nedopc/zxevo/docs/zxevo_firmware_update_eng.odt

(version 11/13/2010)

www.nedopc.com

ZX Evolution.

Firmware update

manual

# Description

Boot loader can update peripheral microcontrollers (ATMEGA128) flash memory.

Peripheral microcontrollers flash memory content FPGA configuration and program for controller (base configuration of ZX Evolution).

User can update base configuration (firmware) manually.

Official configuration locate in NedoPC site (www.nedopc.com). But user can to use alternate configuration from other developers.

Boot loader can update configuration (firmware) with two different way:

- from SD memory card;
- via null-modem cable from other computer.

# Update from SD memory card

1. File with configuration (ZXEVO_FW.BIN) write to root directory of SD memory card. Memory card must be formatted FAT12, FAT16 or FAT32. Insert SD memory card to SD holder on ZX Evolution.
2. Hold pressed soft reset button (hold shorted soft reset contacts on board) and switch on power to ZX Evolution or press on few time hard reset button (short on few time hard reset contacts).

Configuration will update in some seconds.

Updating process is not indicated on display. Errors is signaled by PWR LED (VD6) and beeper. Number of beeps according to next errors:

- 1 – SD memory card not detected;
- 2 – error on reading sector on SD memory card;
- 3 – supported file system not found on SD memory card;
- 4 – file with configuration not found on SD memory card;
- 5 – file with configuration is bad.

# Update via null-modem cable from other computer

1. RS232 connector of ZX Evolution connect via null-modem cable to other computer. Run terminal program on other computer (speed 115200, without parity checking, 8 bit, 2 stop-bit, without CTS).
2. Hold pressed soft reset button (hold shorted soft reset contacts on board) and switch on power to ZX Evolution or press on few time hard reset button (short on few time hard reset contacts).
3. After receiving message «Try update from RS-232...» send file with configuration (ZXEVO_FW.BIN) via X-Modem-CRC protocol.

Can used simple null-modem cable (only three wires):

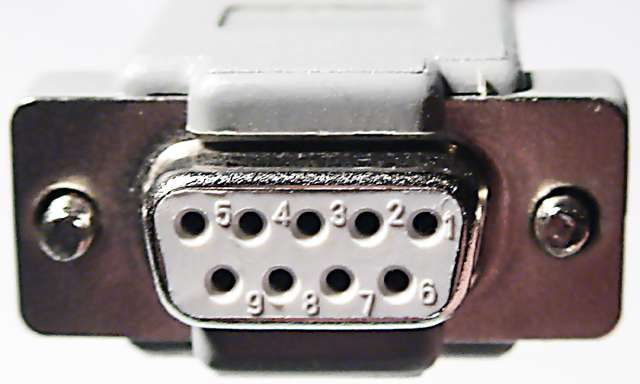
[picture p1: figure]

X1, X2 – D-Sub9F

# Example: Update configuration via null-modem cable from HyperTerminal program

RS232 connector of ZX Evolution connect via null-modem cable to PC computer.

1. Start HyperTerminal program on PC.

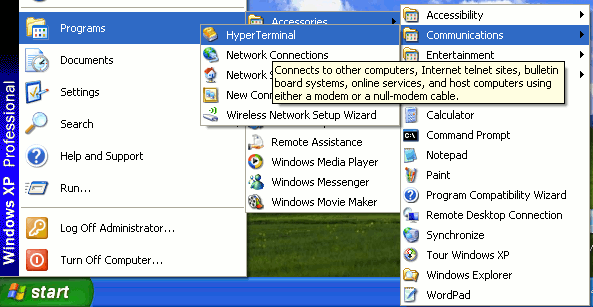
[picture p2: figure]

If HyperTerminal started first time than it view next dialogs.

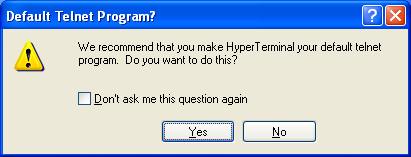
[picture p3: figure]

Set checkbox and press “Yes”.

Set area code (if area code not set and terminal start than dialog views again).

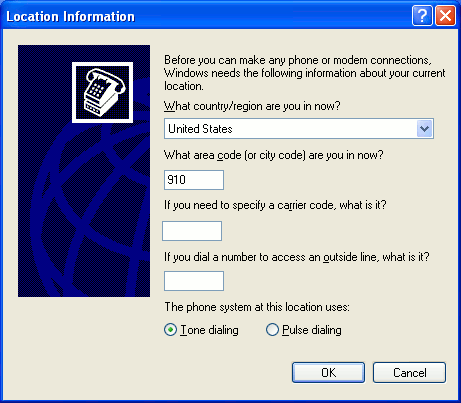
[picture p4: figure]

2. Set the name for connection. Connection settings will saved by this name.

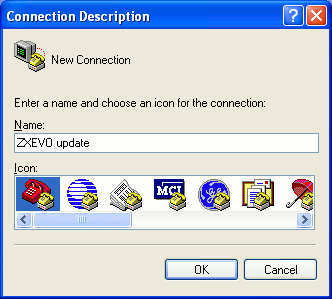
[picture p5: figure]

3. Select port.

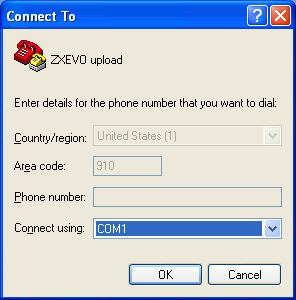
[picture p6: figure]
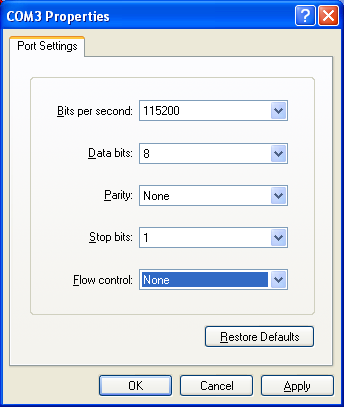
[picture p7: figure]

4. Set port settings as in picture.
5. Hold pressed soft reset button (hold shorted soft reset contacts on board) and switch on power to ZX Evolution or press on few time hard reset button (short on few time hard reset contacts).

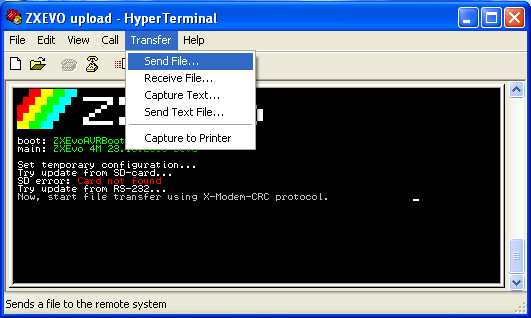
[picture p8: figure]

6. Select file with configuration (ZXEVO_FW.BIN), set protocol «X-Modem» and press button “Send”.

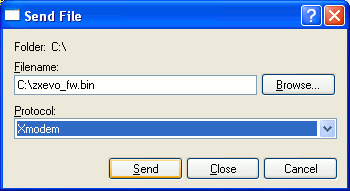
[picture p9: figure]

Warning: If not send file during one minute than ZX Evolution exit from update mode and start current configuration.

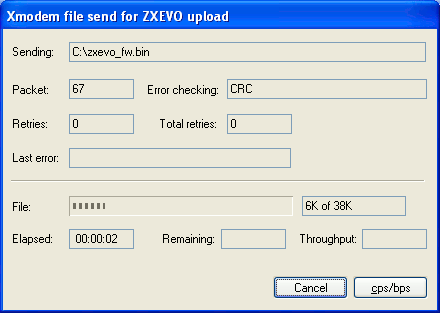
[picture p10: figure]

Transfer take some seconds.

If configuration updated successfully than string with it name and version is shown. Computer start up with new configuration.

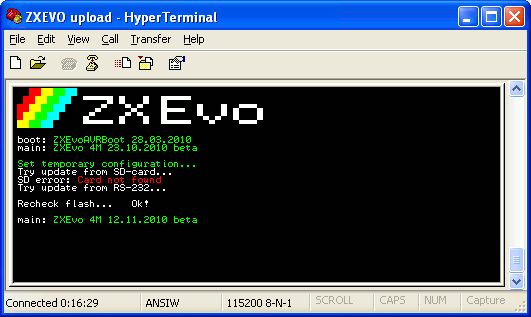
[picture p11: figure]

ZX Evolution. Firmware update manual.
