nedopc/zxevo/docs/schem1.png

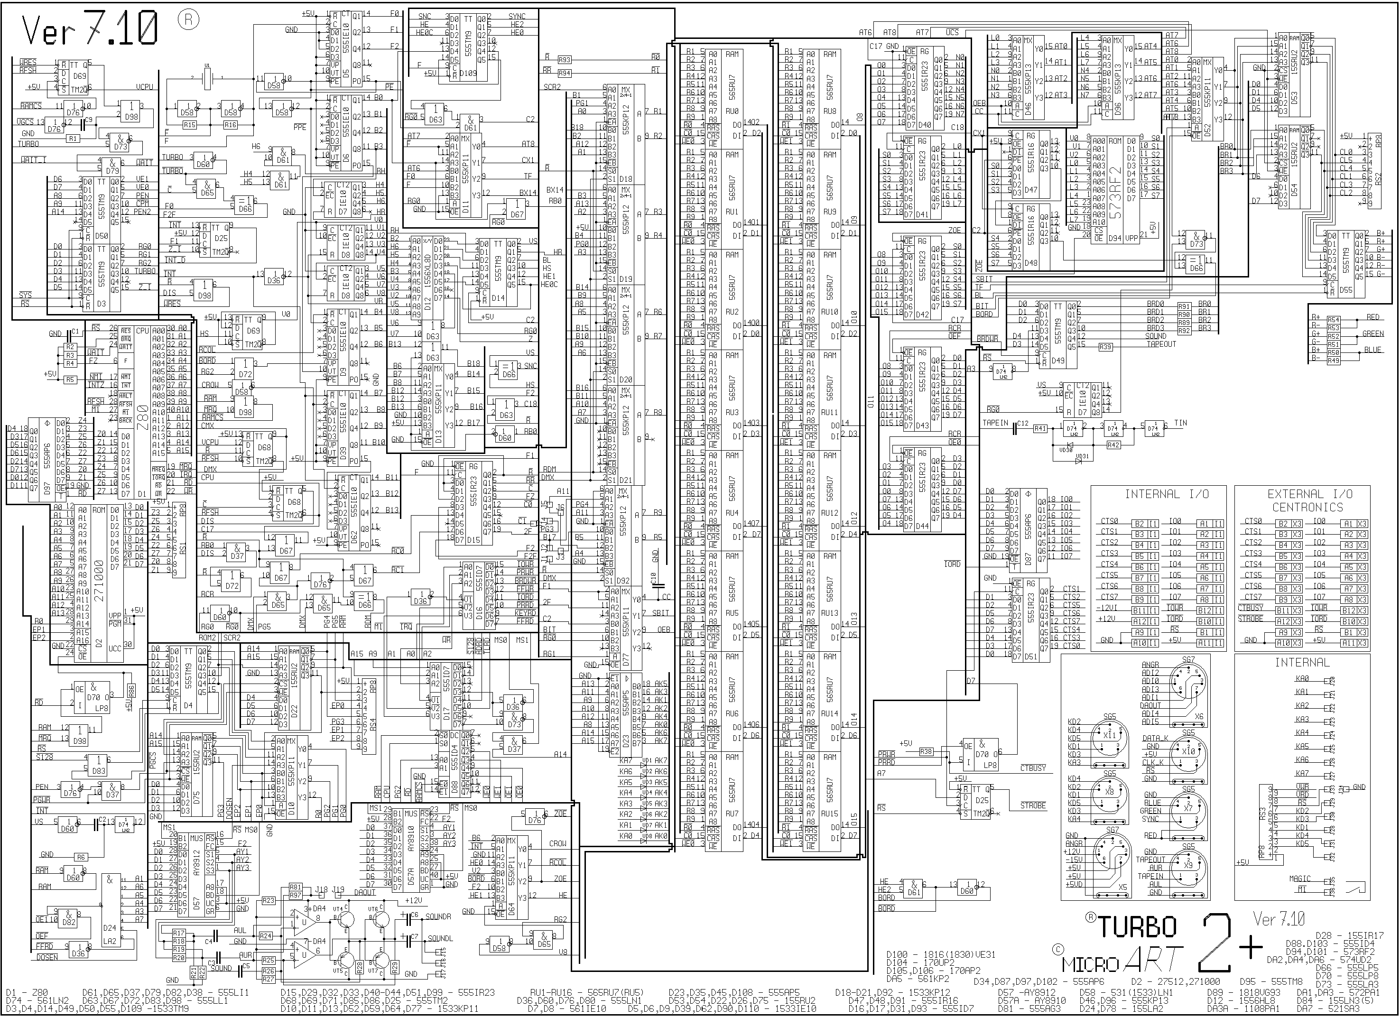
docs/schem1.png
