nedopc/zxevo/docs/schem2.png

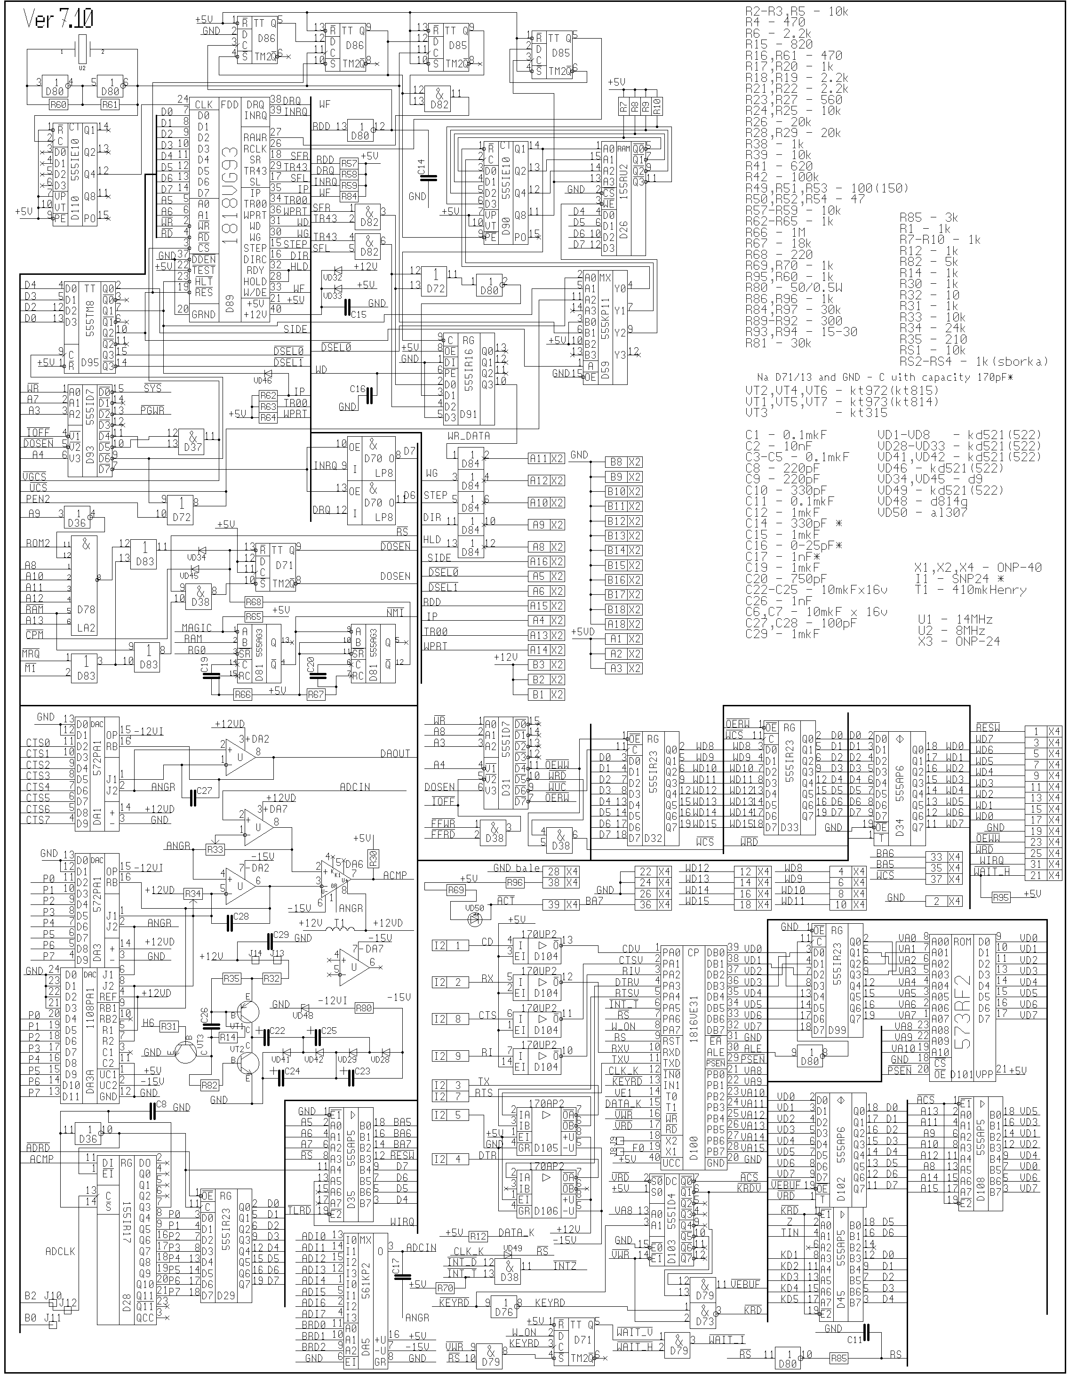
docs/schem2.png
