nedopc/zxevo/fpga/prefetch/dram/arbiter.png

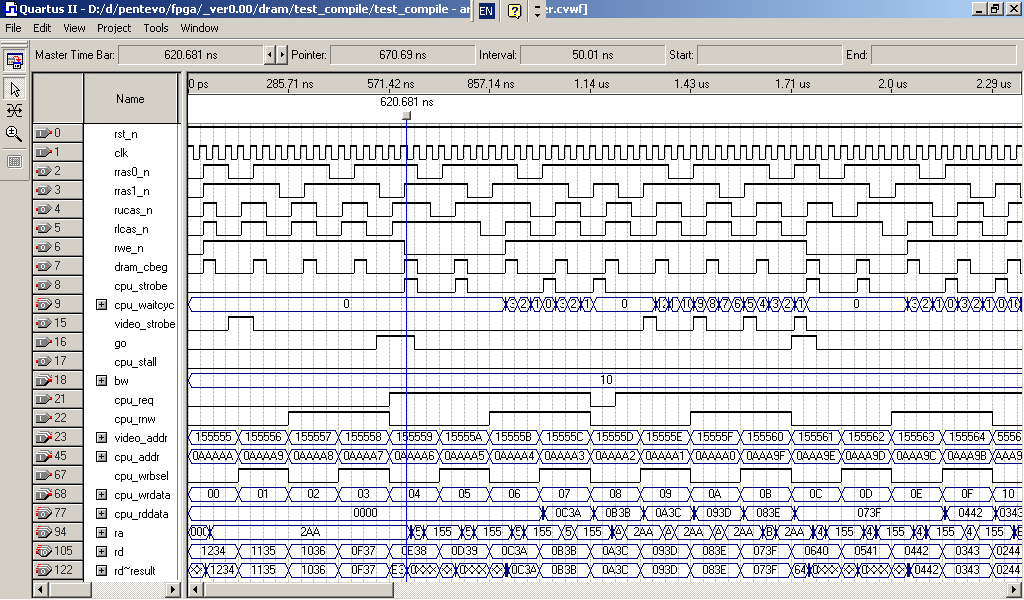
fpga/prefetch/dram/arbiter.png
