nedopc/zxevo/fpga/prefetch/video/shiftted_attr.gif

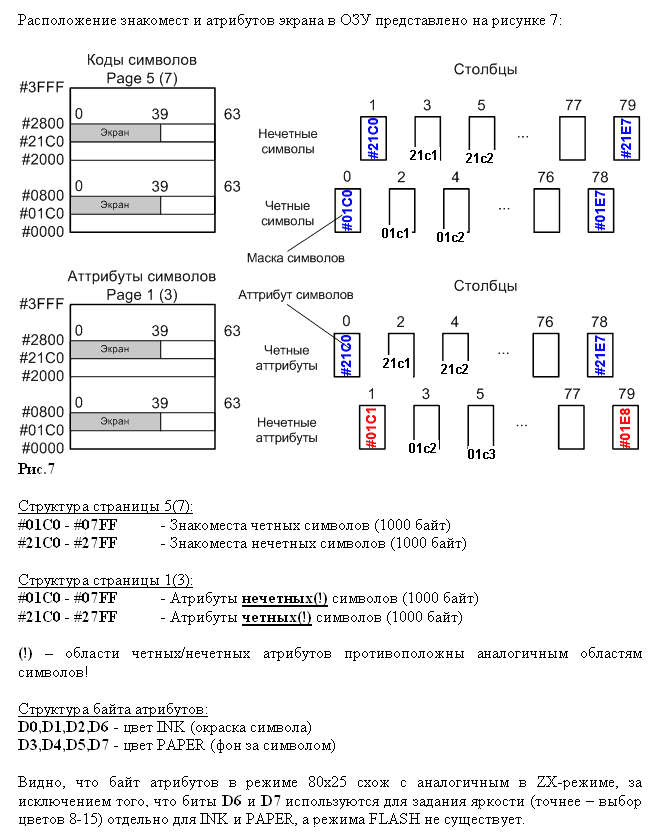
fpga/prefetch/video/shiftted_attr.gif
