nedopc/zxevo/unsupported/flasher/fpga/ZX_FONT.BMP

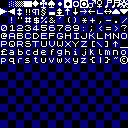
unsupported/flasher/fpga/ZX_FONT.BMP
