nedopc/zxevo/test_n_service/trunk/fpga/font_6x8.bmp

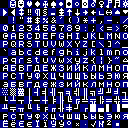
test_n_service/trunk/fpga/font_6x8.bmp
