nedopc/zxevo/pcad/rev_c/TODO.txt

ЗАМЕЧЕННЫЕ НЕДОЧЕТЫ на рев.С:
- Разъем TapeIN (X21) диаметр сигнального пина должен быть увеличен до 2.2мм (компонент RSA103)
- Разъем VGA (X7) нужно отодвинуть вглубь платы на 0.6мм
- Разъем RS232 (X6) нужно отодвинуть в сторону разъема SD на 0.8 .. 1.0мм
- Джампер J1 нужно отодвинуть на 0.5 .. 1.0 мм от X2
- Надпись IDE нужно сделать крупным шрифтом
- Надпись Tape нужно сделать все буквы заглавными
- Надпись RS232 нужно отодвинуть от края платы на 2мм

PCB C2:
+ Разъем TapeIN (X21) диаметр сигнального пина должен быть увеличен до 2.2мм (компонент RSA103)
+ Разъем VGA (X7) нужно отодвинуть вглубь платы на 0.6мм
+ Надпись Tape нужно сделать все буквы заглавными

PCB:
+ Добавил 2 милиметра к плате, чтобы слот влез;
+ Сделал board под miniITX стандарт (ZXBUS слот не лезет).

SCH:
+ Сделал вход для TAPEIN на RSA103;
+ Сделал USB-RS232 bridge на FT232RL;
+ Заменил D3 на 29F040-K (PLCC32 без панельки);
+ Убрал кнопку Hard Reset, оставил только контакты;
+ Добавил IORQ2 и IORQGE2 на XS1;
+ Добавил коннектор (X8,X9) для подсоединения PAL кодера;
+ Добавил +5V и CSYNC (через джамперы) на VGA разъем;
+ Добавил +5V на 10 вывод X19 (как у Мультикарты Caro);
+ Подпачил ZXBUS (добавил 31 контакты);
+ Убрал AT POWER коннектор питания;
+ Устранил перепутывание каналов (левый/правый) на ST-214C (X10);
+ Добавил еще 2 аудио-входа;
+ Добавил PRN интерфейс по стандарту AY принтер;
+ Убрал PAL coder;
+ Убрал R29 (замкнул);
+ Замкнул 4 (DTR) и 6 (DSR) выводы RS232 разъема;
+ Добавил альтернативный разъем держателя SD карт;
+ TurboKey переименован в NMIKey;
+ Выводы 4,5 ATMEGA128 управляют множителем PLL (ICS501M): убран разъем X8, убраны джамперы J2,J3;
+ Убрал лишние резисторы в floppy контроллере;
+ Заменил CPU в DIP корпусе на в QFP корпусе, убрал Z80 в SOIC корпусе (D1*).

LIB:
+ Добавил компонент RSA103;
+ Добавил компонент FT232RL;
+ Добавил 29F040-K PLCC32 (без панельки) ;
+ Добавил компонент 74HCT125;
+ Добавил компонент SP0503BATH;
+ Заменил via на pad-mounting hole у ATXPOWER;
+ Заменил via на pad-mounting hole у SDC09W4;
+ Переименовал EP1K30Q208 в EP1K50Q208;
+ Добавил компонент MINI-USB;
+ Добавил компонент CP2102;
+ Добавил компонент SD01-AP0003;
+ Добавил компонент Z84C0020FEC;
+ Уменьшил диаметр контактов у ATPOWER.
