nedopc/zxevo/tools/unreal_fix/0.37.6/tmp/README

фикс анрыла 0.37.6
делать дифф влом, кучей так в свн.
Оригинальный сорец в комплекте.

1. компилять c.bat -- это для msvc2008. Установки венды для того чтобы компиляция работала --
   см. http://dlcorp.nedopc.com/viewtopic.php?f=28&t=834
   Как вариант, можно прописать установку INCLUDE и LIB переменных в батник, см. как у deathsoft'а.

2. Фикс быстрый и говнокодный. Мифическое ATM3 заменено на фичи пентевы. Но в конфиге оно до сих пор ATM3.
   Конфиг, кстати, сразу настроен под пентеву и zxevo.rom. Всё в комплекте.

Список фич:

1. модель памяти пентевы - порт ЕФФ7 и мегабайт через 7ффд.
2. прерывания через фф77 невозможно запретить
3. Доступны видеомоды через ефф7: алко16ц и хардваре мультиколор
4. впилен текстовый режим #7 (1страничный), выпилен атм2 256х192 текстовый режим.
5. запись фонтрома сделана как в железе - по любому адресу, а не только по 0-2047
6. впилено РАМ0 в 0000-3ффф через ефф7, не тестировал.
7. ещё что-то, мог забыть.

Текстовый режим #7 протестирован той же прогой, которой я тестировал его в железе.

Фичи памяти - аласмом с драйвером P1MB, моими памятетестами.

Экраны пентагона -- ballquest'ом (оба работают - алко16ц и атм16ц), HexaFixa (хвмц).

10.01.2012, lvd.
