nedopc/zxevo/pcad/rev_b/TODO.txt

              ZX Evo revision B
             ===================

+ Исправил шаблон PS/2 клавиатуры-мыши
+ Увеличил площадь радиатора у 78M05 примерно в два раза
+ Исправил ОЕ на ICS501
+ 12V на слоты подается теперь через джампер (чтобы ААА не жжег)
+ добавил направляющие для разъема ATX питания
+ увеличил контактные площадки дросселей
+ уменьшил размер платы
+ убрал J4
+ замкнул OE ICS501 на +5в (по совету LVD)
+ сделал у диодов 4148 универсальную площадку (на смд и выводные)
+ у ZXBUS сделал указатель первого вывода
+ исправил ошибку сброса ВГ93 (завел VG_RES на D19)
+ сделал ключ FDD как на ПЦ платах (5-ый контакт) 
+ добавил надписи "HDD Led", "PWR Led", "ZX Keyboard/ZX Joystick", "Slot1", "Slot2"
+ опустил разъем VGA чтобы было паралельно DB15
