nedopc/zxevo/docs/revC/zxevo_sch_revc.pdf

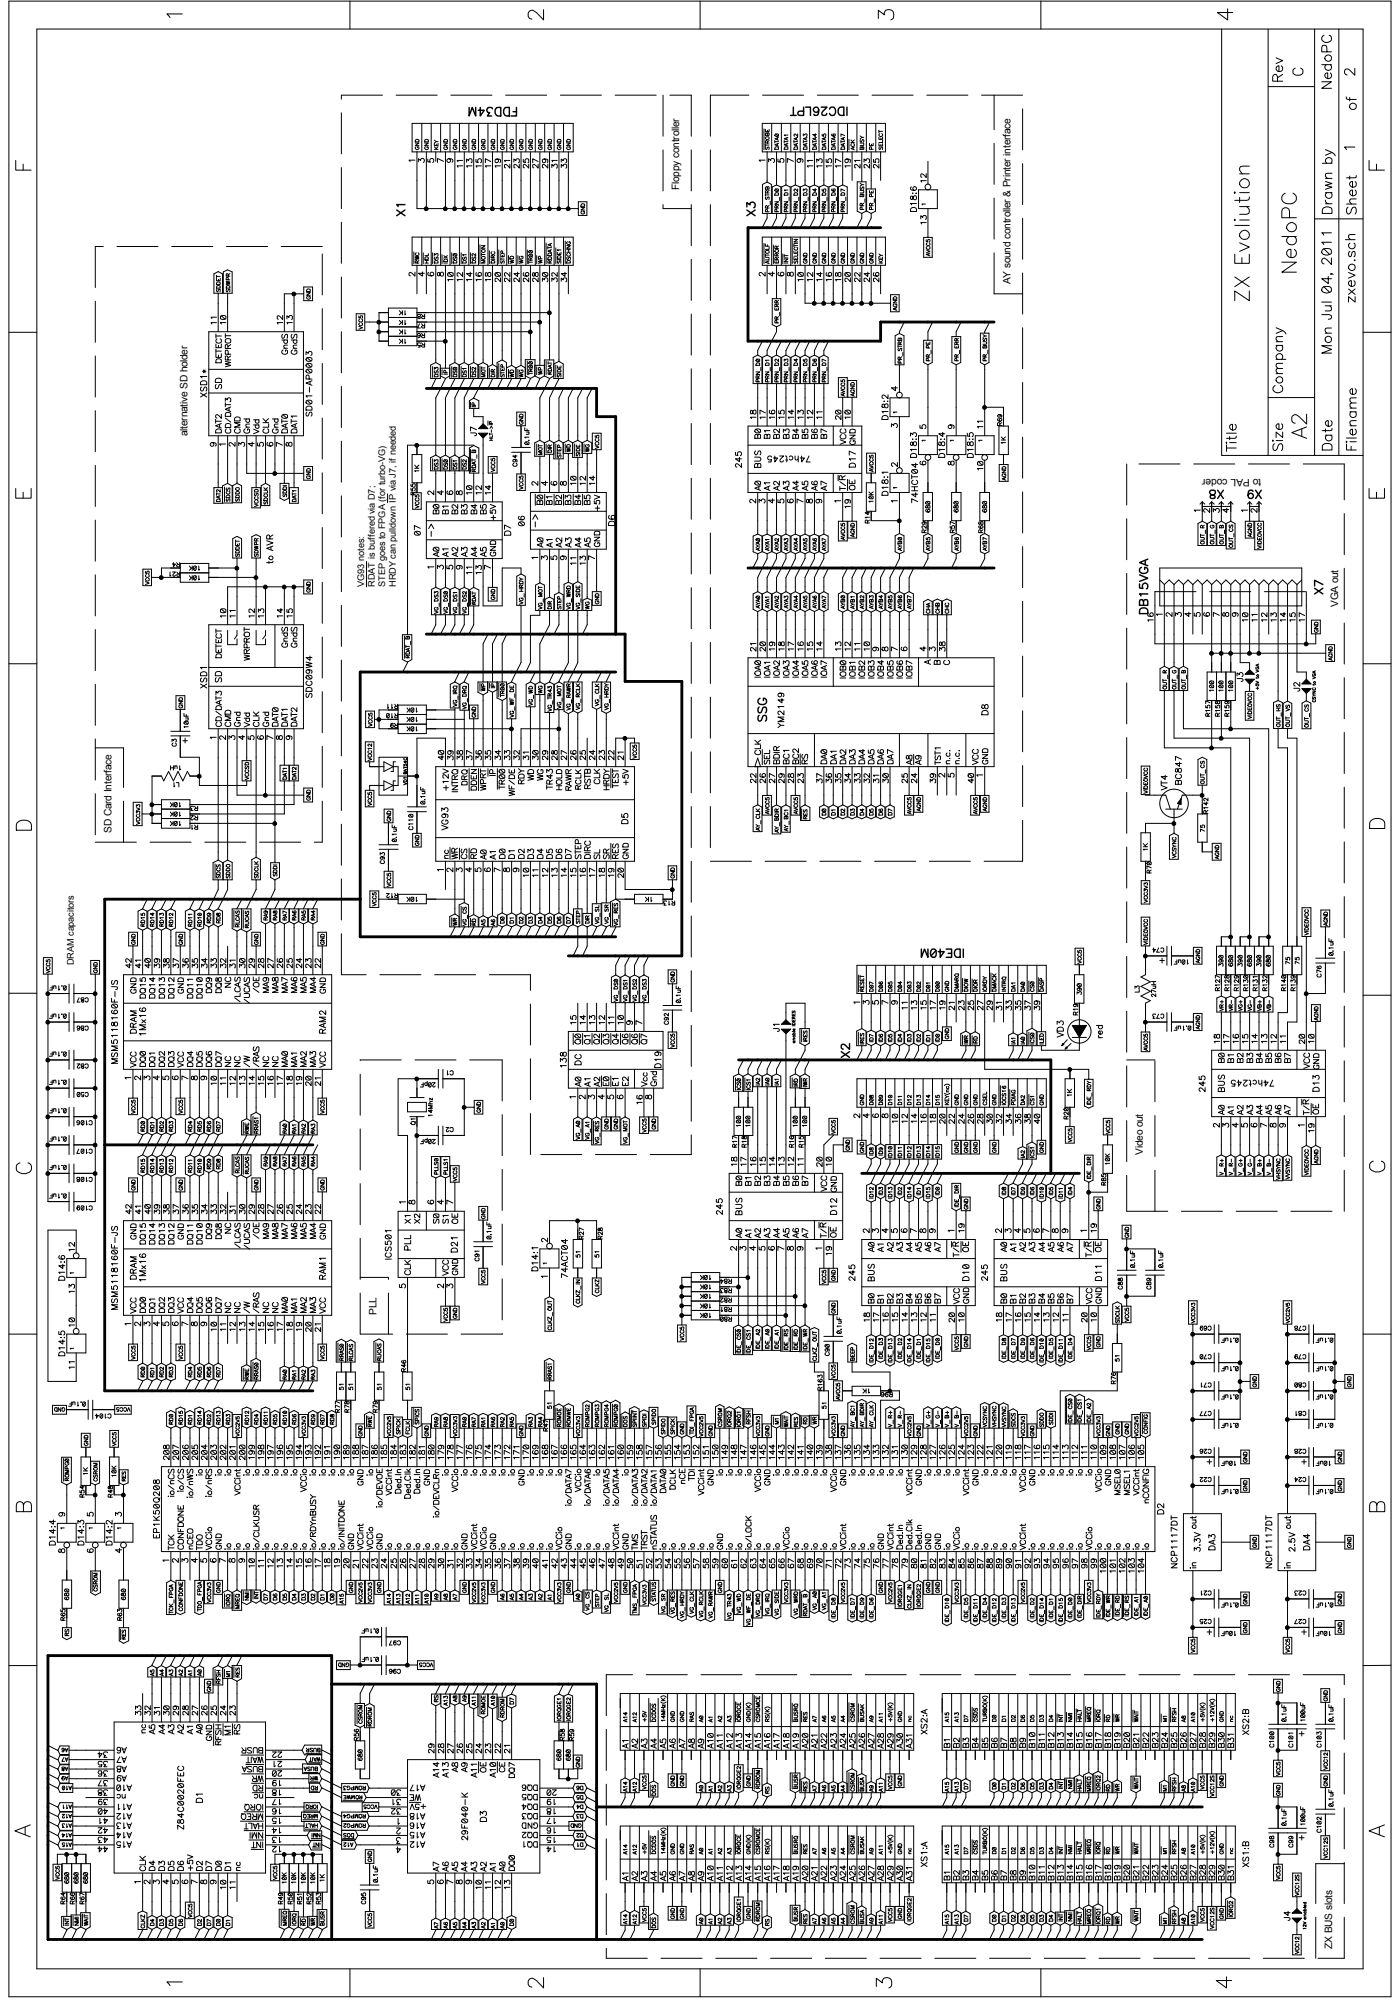
[picture p55: page 1]
PLL; VGA out; DRAM capacitors; Floppy controller; Video out; VG93 notes:

AY sound controller & Printer interface

alternative SD holder

HRDY can pulldown IP via J7, if needed

STEP goes to FPGA (for turbo-VG)

RDAT is buffered via D7;

SD Card Interface

ZX BUS slots

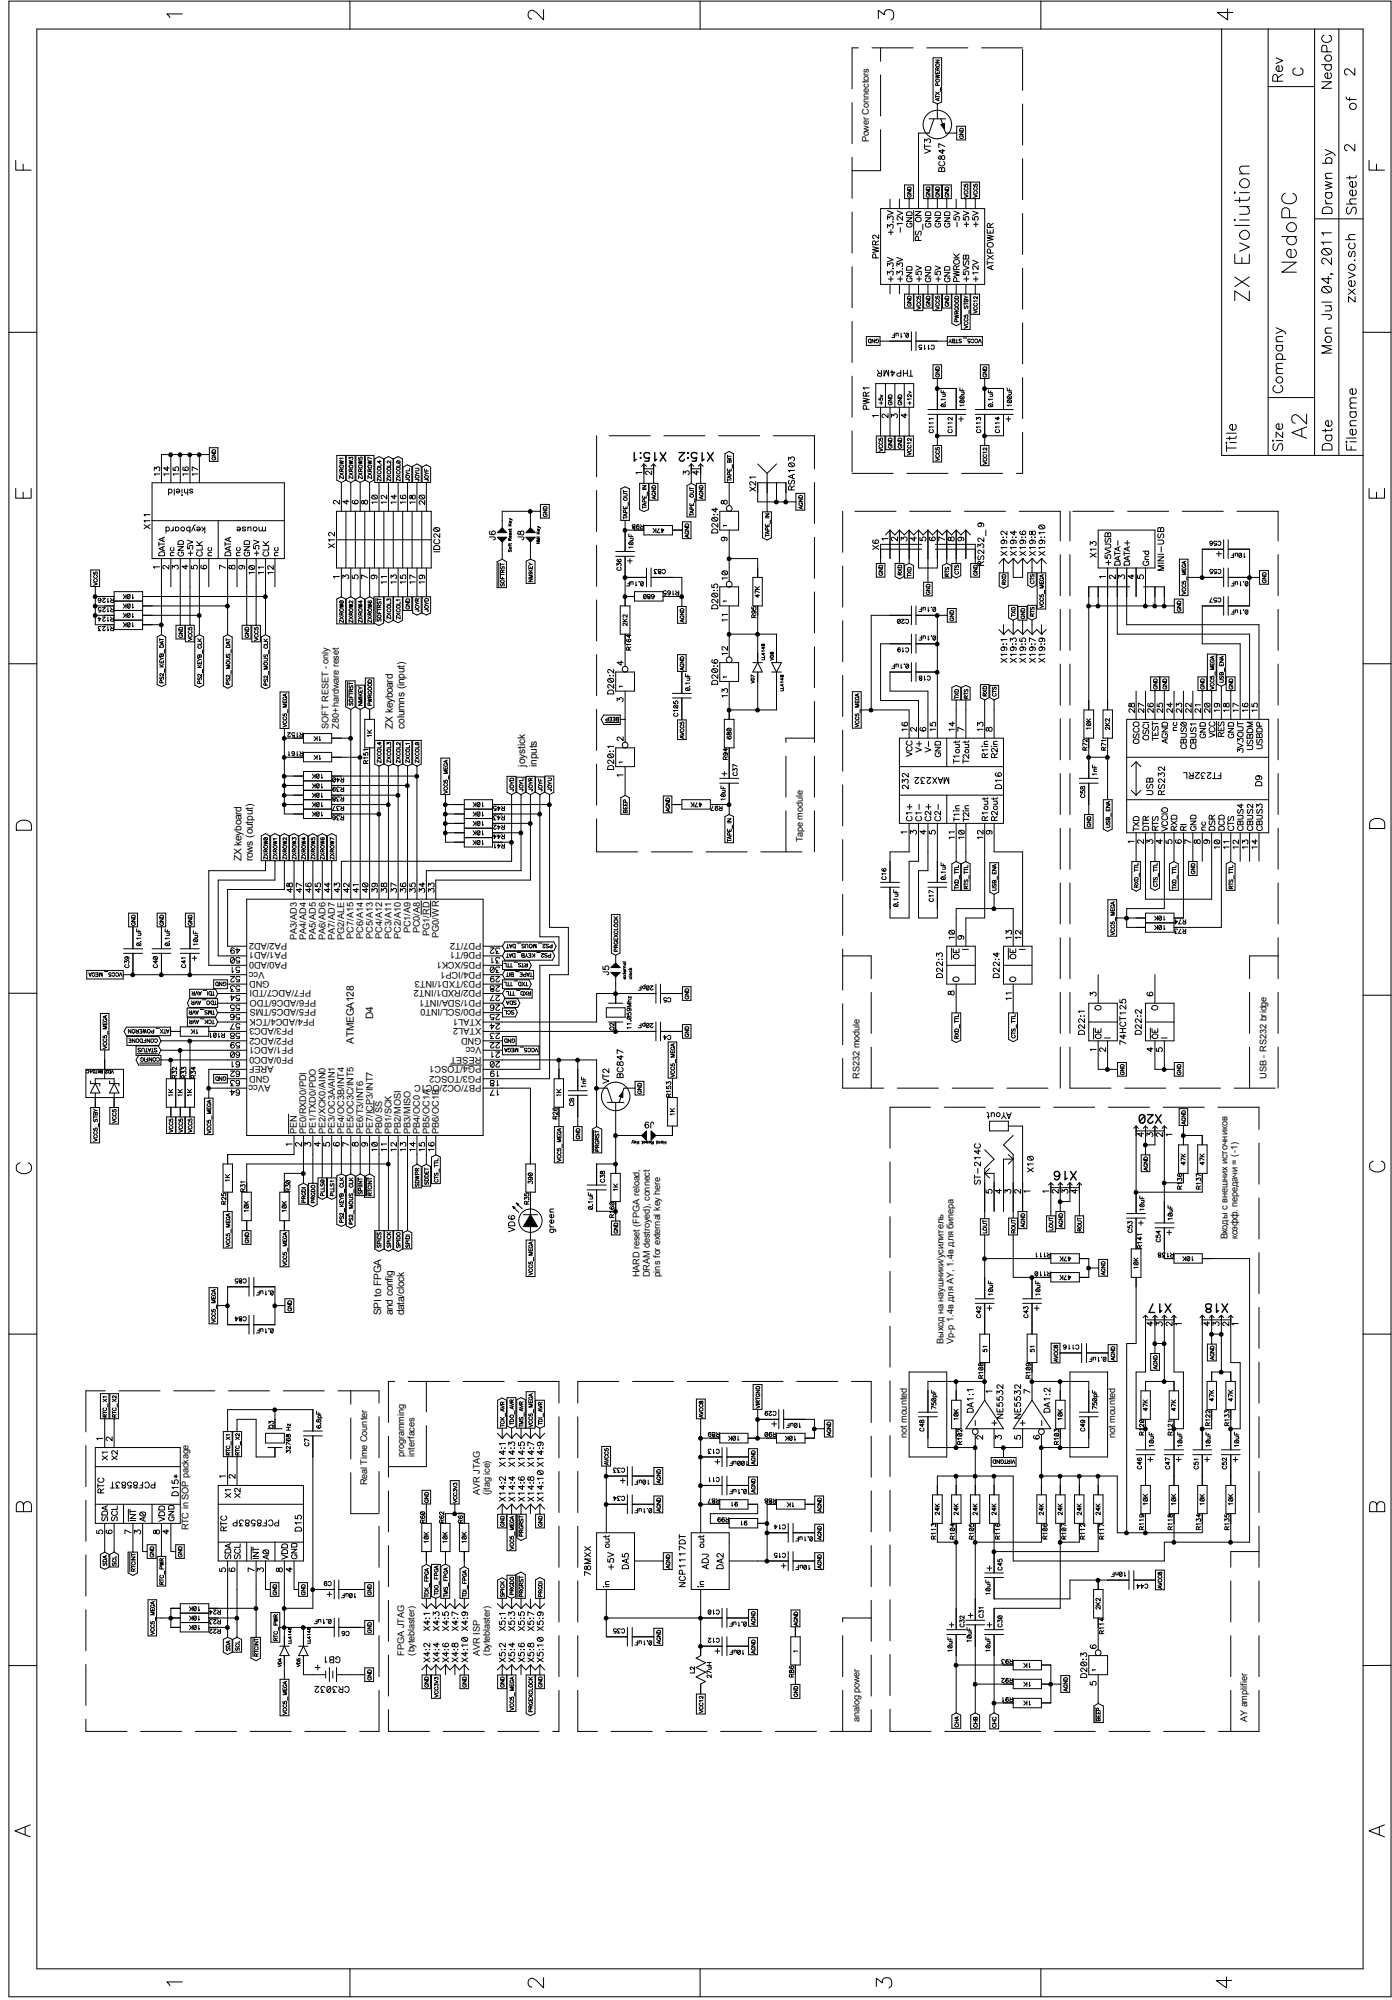
[picture p56: page 2]
not mounted; RS232 module; Tape module; AVR ISP; (byteblaster); ZX keyboard; rows (output); FPGA JTAG; and config; data/clock; joystick; inputs; analog power; AY amplifier; коэфф. передачи = (-1); AVR JTAG; (jtag ice); Z80+hardware reset; Power Connectors; programming; interfaces; columns (input); USB - RS232 bridge; PB3/MISO PC1/A9; PE5/OC3C/INT5 PC7/A15; PE2/XCK0/AIN0; PE6/T3/INT6; PE7/ICP3/INT7; PB1/SCK; PB2/MOSI; PE0/RXD0/PDI; PE1/TXD0/PDO; PE3/OC3A/AIN1; PE4/OC3B/INT4 PG2/ALE; ATMEGA128

SOFT RESET - only

Входы с внешних источников

HARD reset (FPGA reload,

DRAM destroyed), connect

pins for external key here

Vp-p 1.4в для AY, 1.4в для бипера

Выход на наушники/усилитель

SPI to FPGA

Real Time Counter

RTC in SOP package
