nedopc/zxevo/docs/revA/schematics_revA.pdf

# Сигналыс краснымпроводом-перемычкой

# можнодвигатьпо ногам, без таковой -

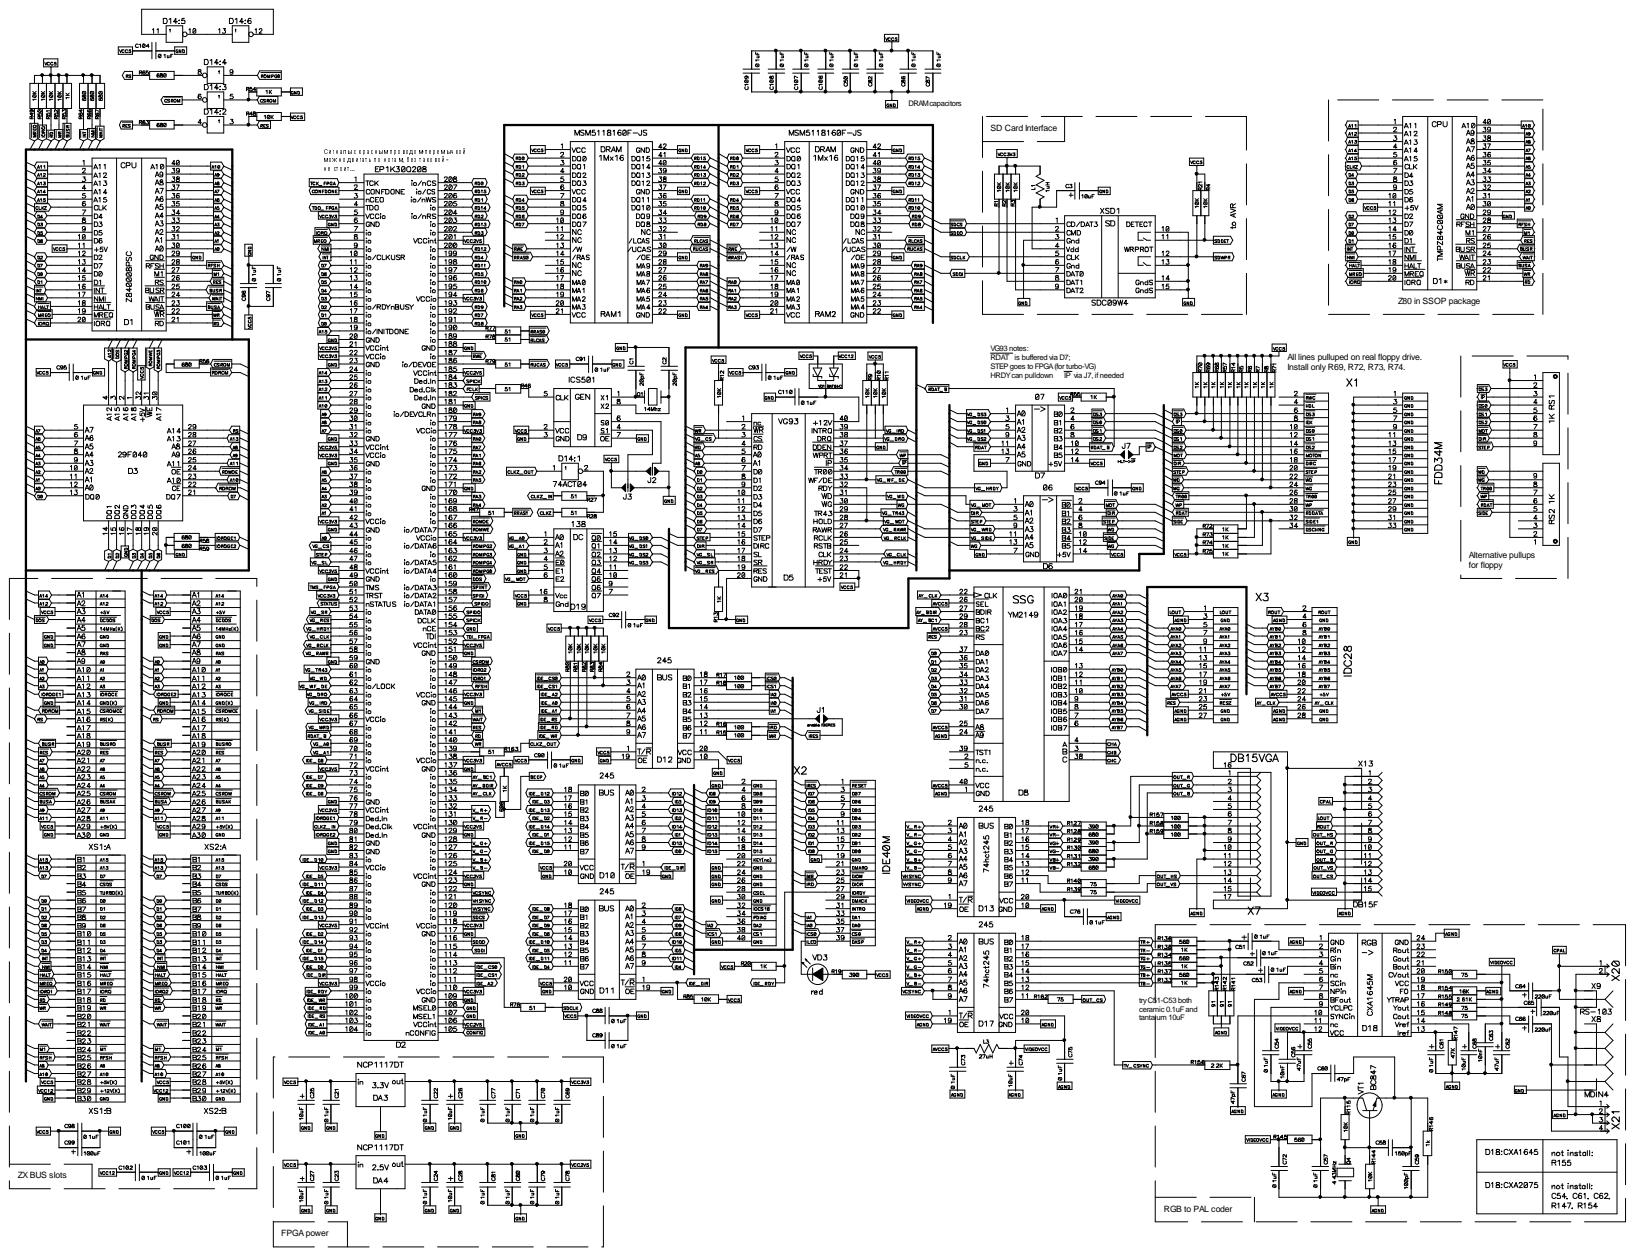
[picture p57: page 1]
FPGA power; DRAM capacitors; Alternative pullups for floppy; try C51-C53 both ceramic 0.1uF and tantalum 10uF; не стоит...

SD Card Interface

Z80 in SSOP package

VG93 notes:
RDAT is buffered via D7;
STEP goes to FPGA (for turbo-VG)
HRDY can pulldown IP via J7, if needed

All lines pulluped on real floppy drive.
Install only R69, R72, R73, R74.

ZX BUS slots

RGB to PAL coder

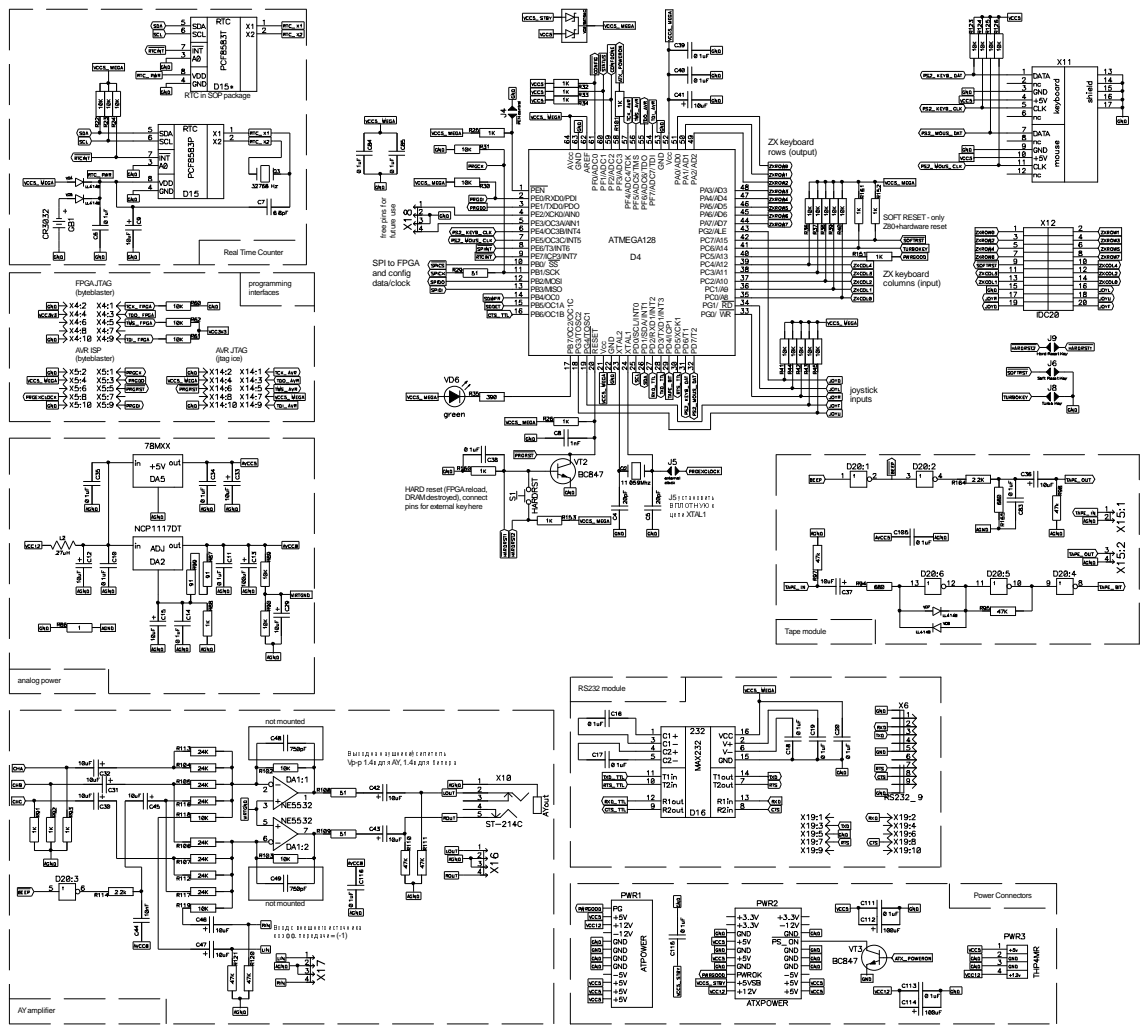
[picture p58: page 2]
AY amplifier; analog power; AVR JTAG (jtag ice); programming interfaces; future use; joystick inputs; not mounted; AVR ISP (byteblaster); Tape module; J5 установить ВПЛОТНУЮк цепи XTAL1; ZX keyboard rows (output); Power Connectors; ZX keyboard columns (input); FPGA JTAG (byteblaster); PG3/TOSC2; Vcc; GND; PF1/ADC1; XTAL1 PF4/ADC4/TCK; PD2/RXD1/INT2 PF7/ADC7/TDI; PD5/XCK1 PA0/AD0 PEN; PG4/TOSC1; RESET; XTAL2; PD0/SCL/INT0; AVcc; AREF PF0/ADC0; PF2/ADC2; PF3/ADC3; PF5/ADC5/TMS; PD3/TXD1/INT3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

RTC in SOP package

free pins for

SOFT RESET - only
Z80+hardware reset

Real Time Counter

SPI to FPGA
and config
data/clock

HARD reset (FPGA reload,
DRAM destroyed), connect
pins for external key here

RS232 module
Выходна наушники/усилитель
Vp-p 1.4в для AY, 1.4в для бипера
Вход с внешнегоисточника
коэфф. передачи = (-1)
