nedopc/zxevo/docs/revb/zxevo_sch_revb.pdf

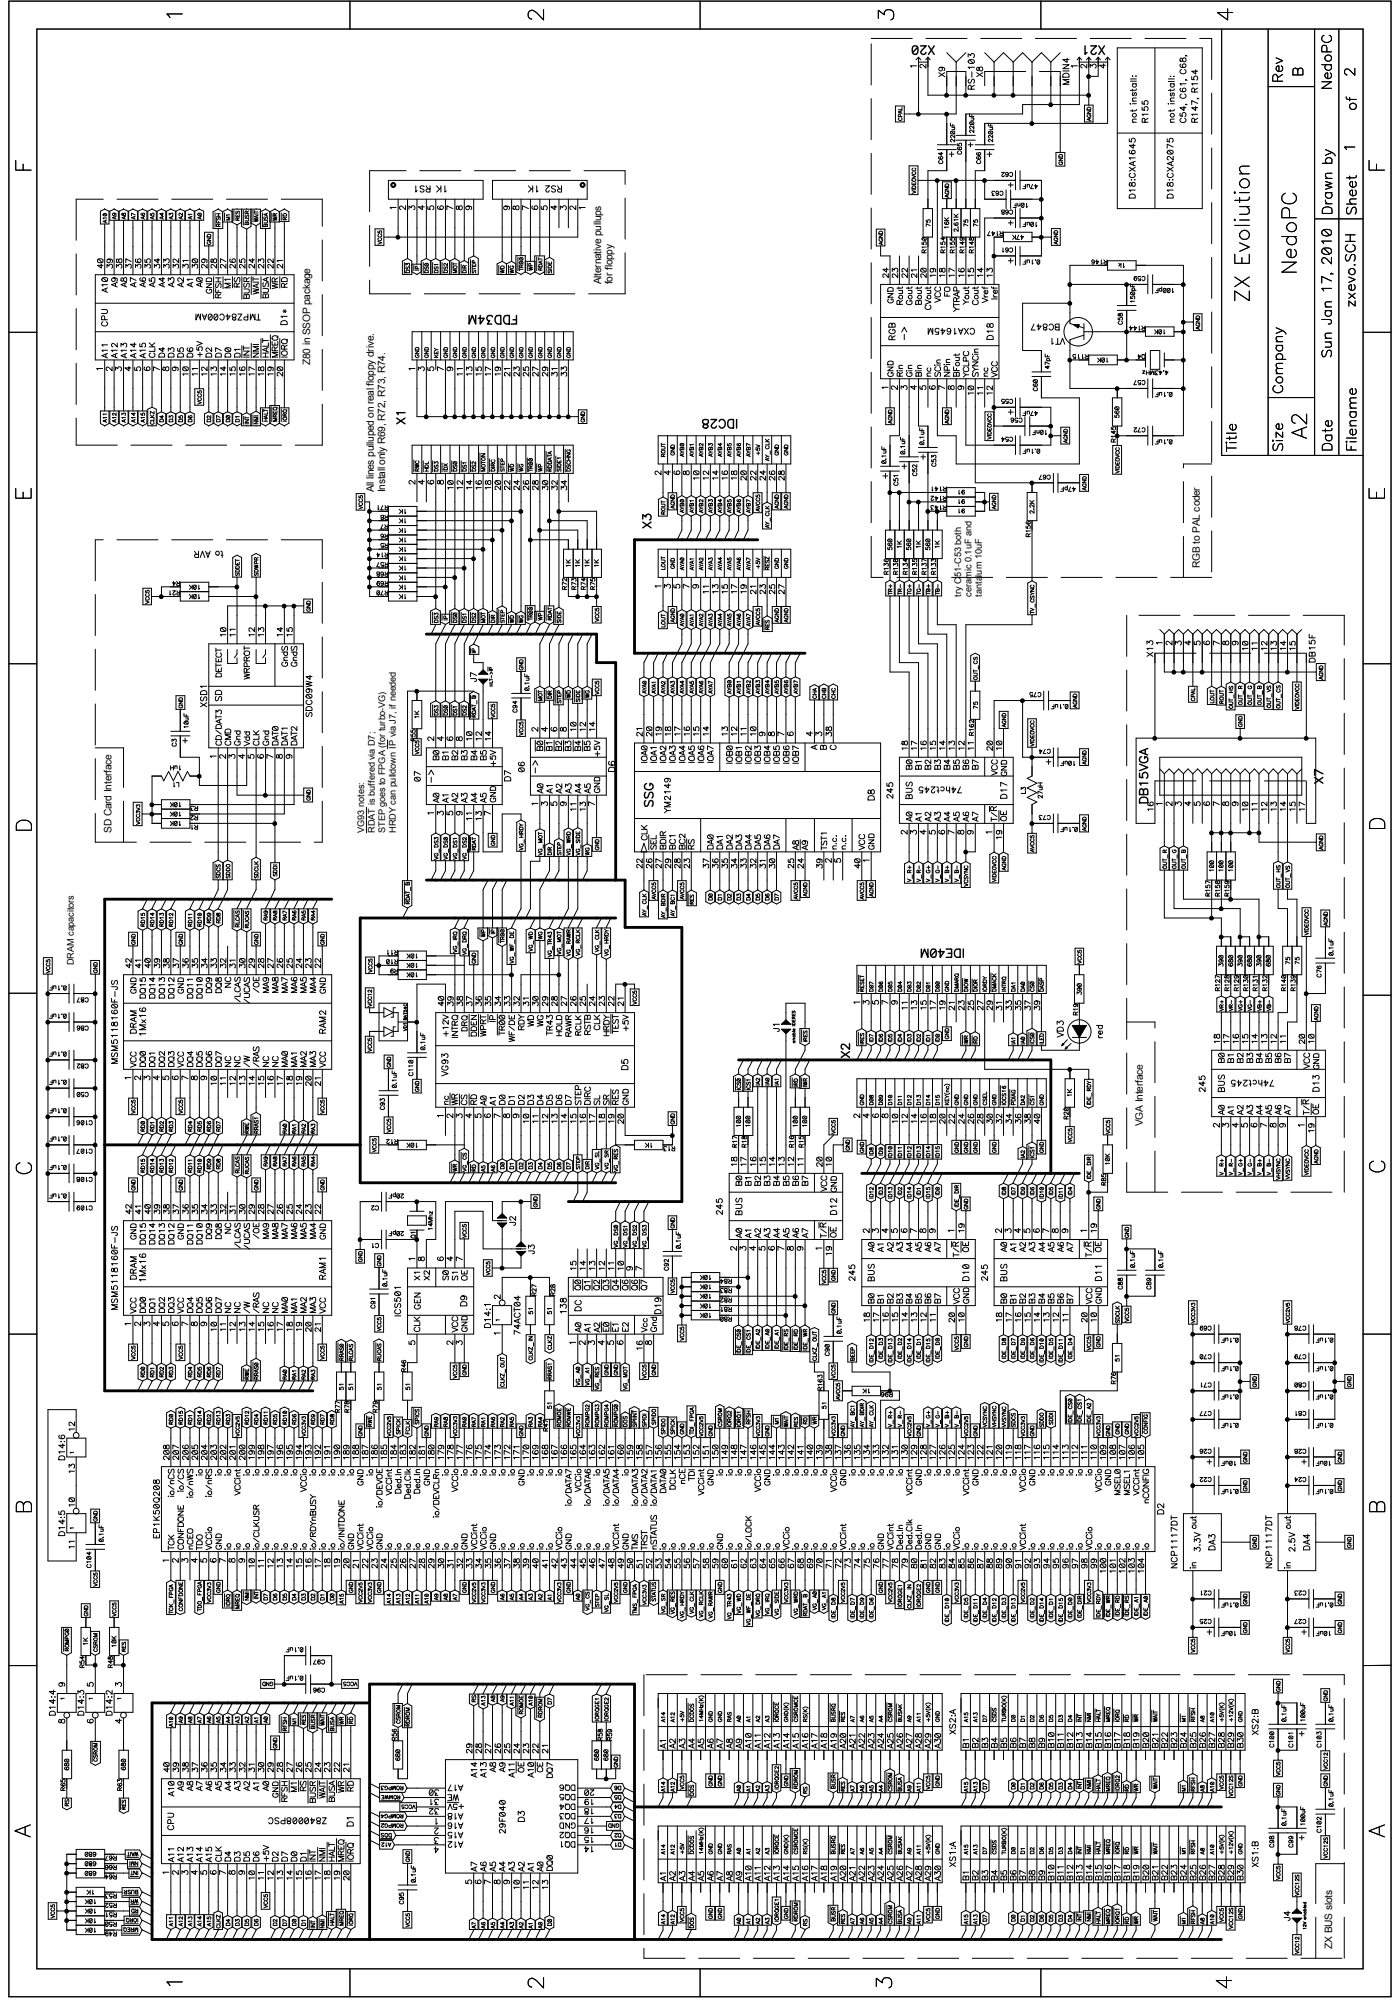
[picture p59: page 1]
DRAM capacitors; VGA Interface; VG93 notes:; Alternative pullups; for floppy; Install only R69, R72, R73, R74.; try C51-C53 both; ceramic 0.1uF and; tantalum 10uF

Z80 in SSOP package

All lines pulluped on real floppy drive.

RGB to PAL coder

HRDY can pulldown IP via J7, if needed

STEP goes to FPGA (for turbo-VG)

RDAT is buffered via D7;

SD Card Interface

ZX BUS slots

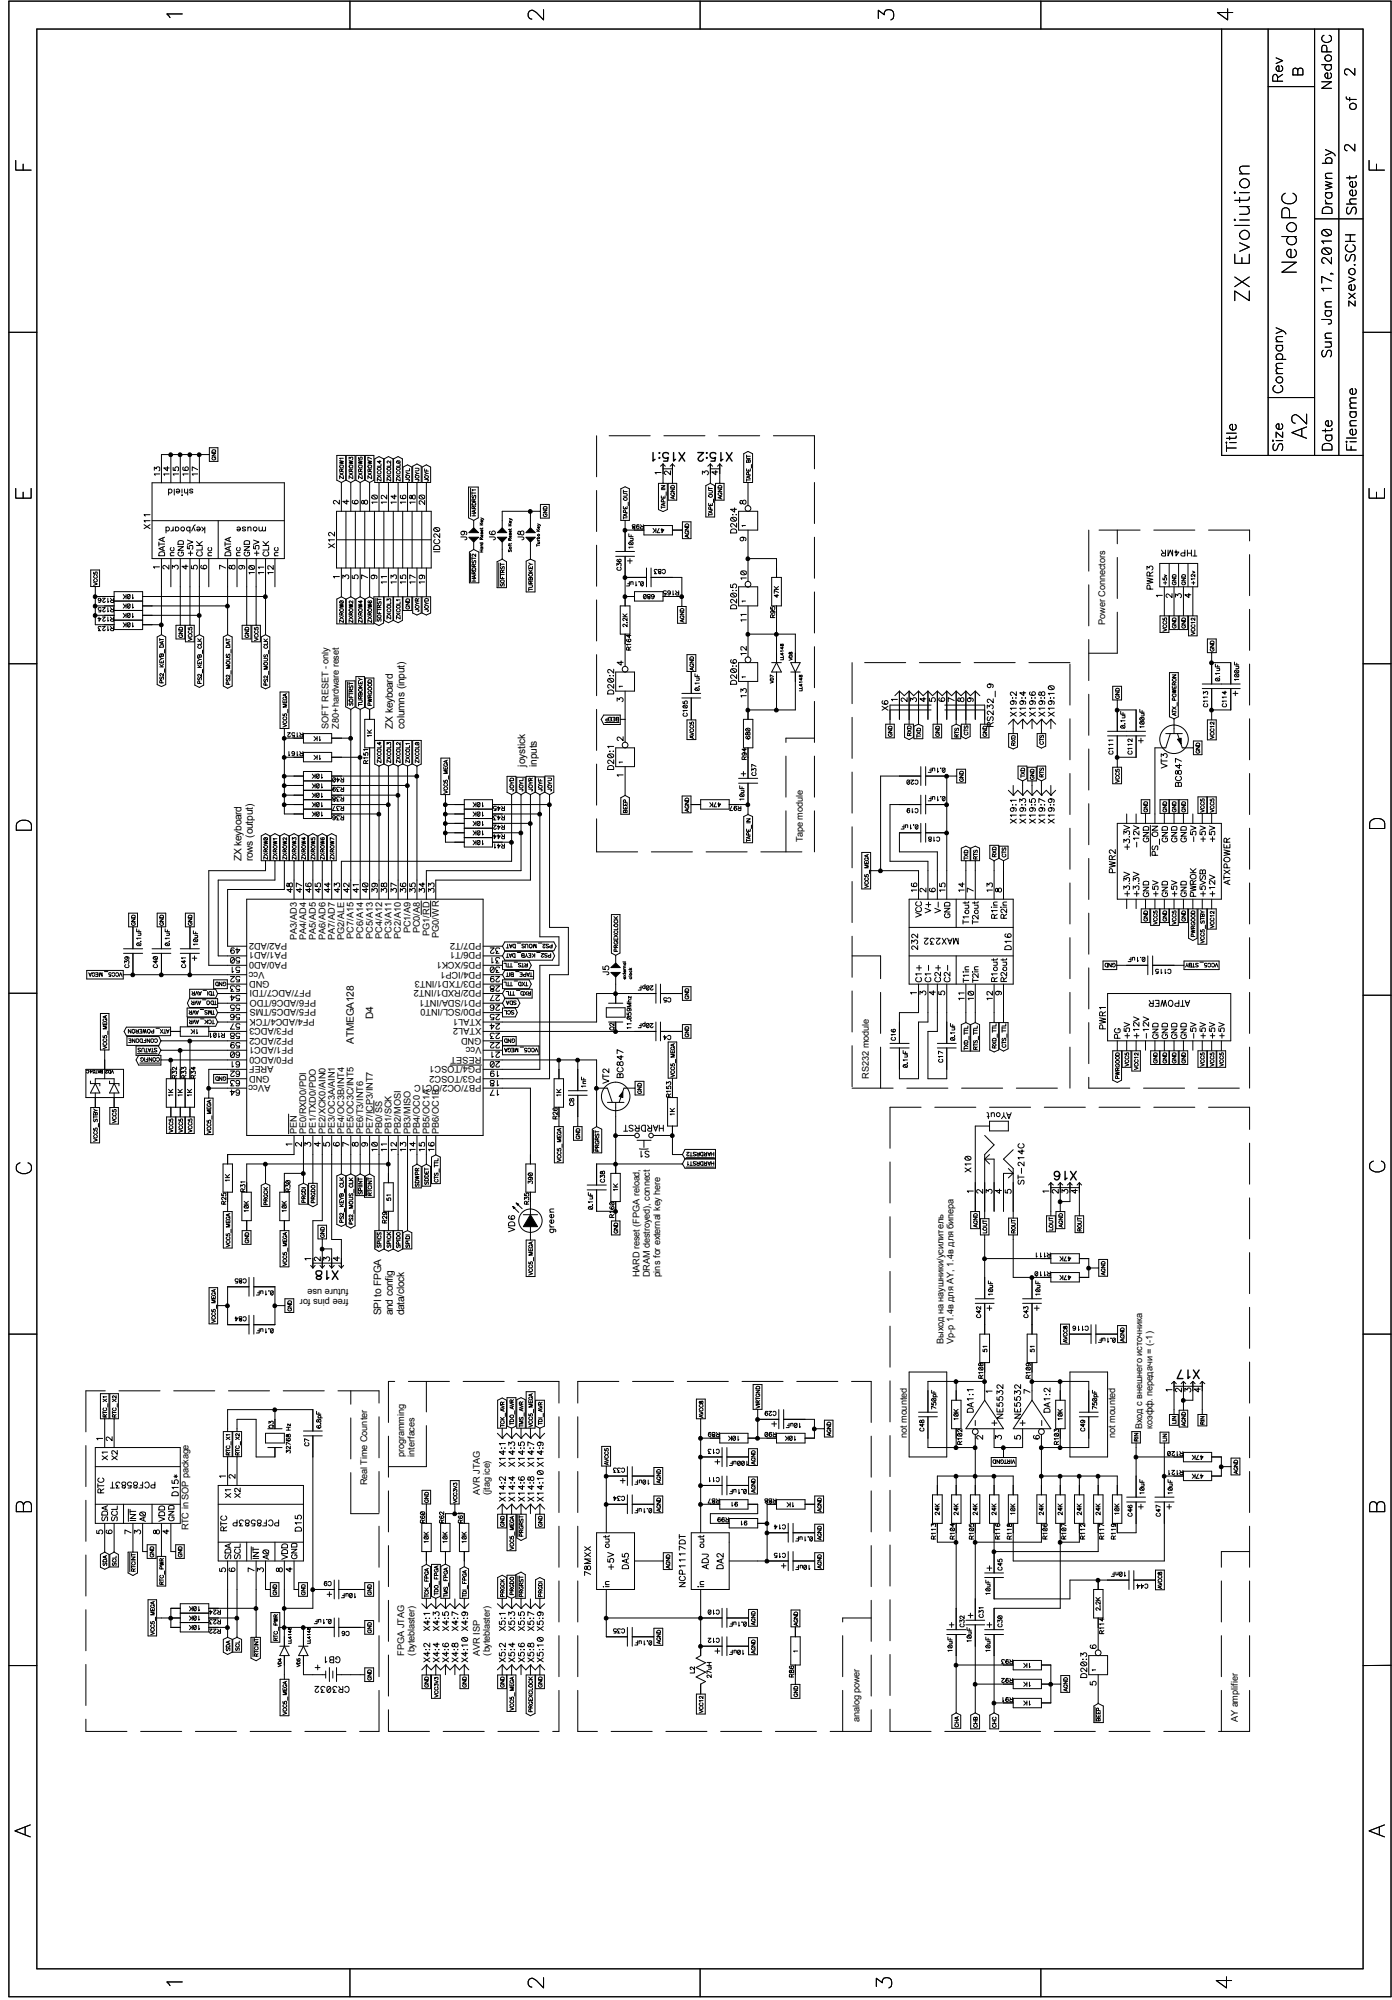
[picture p60: page 2]
not mounted; Tape module; AVR ISP; (byteblaster); RS232 module; ZX keyboard; rows (output); Power Connectors; FPGA JTAG; and config; data/clock; joystick; inputs; analog power; AY amplifier; коэфф. передачи = (-1); AVR JTAG; (jtag ice); Z80+hardware reset; programming; interfaces; columns (input); PB3/MISO PC1/A9; PE5/OC3C/INT5 PC7/A15; PE2/XCK0/AIN0; PE6/T3/INT6; PE7/ICP3/INT7; PB1/SCK; PB2/MOSI; PE0/RXD0/PDI; PE1/TXD0/PDO; PE3/OC3A/AIN1; PE4/OC3B/INT4 PG2/ALE; ATMEGA128

SOFT RESET - only

HARD reset (FPGA reload,

DRAM destroyed), connect

pins for external key here

Vp-p 1.4в для AY, 1.4в для бипера

Выход на наушники/усилитель

SPI to FPGA

Вход с внешнего источника

Real Time Counter

RTC in SOP package
