nedopc/zxevo/(list of files, drawings)

Other design files:
pcad/mick/zxevo_light1.pcb
pcad/rev_a/zxevo.PCB
pcad/rev_b/pentagon.PCB
pcad/rev_c/zxevo.pcb
pcad/rev_c/zxevo_c2.pcb
