nedopc/zxevo/unsupported/solegstar/avr/current/tape.h

#ifndef __TAPE_H__
#define __TAPE_H__

/**
 * @file
 * @brief Tape loading support.
 * @author http://www.nedopc.com
 *
 * Tape loading support.
 */

/** Tape in task. */
void tape_task(void);

#endif //__TAPE_H__
