nedopc/zxevo/fpga/prefetch/sim_top/rom_top.v

// full zxevo ROM here. ATM paging: bas48(0)/trdos(1)/bas128(2)/gluk(3)

module rom(
	input [18:0] addr,
	output reg [7:0] data,
	input ce_n
);


	wire [7:0] word;

`ifdef SPITEST
	spitest_rom spitest_rom( .in_addr(addr), .out_word(word) );
`else
 `ifdef NMITEST
	nmitest_rom nmitest_rom( .in_addr(addr), .out_word(word) );
 `else
	bin2v zxevo_rom( .in_addr(addr), .out_word(word) );
 `endif
`endif

	always @*
	begin
		if( !ce_n )
			data = word;
		else
			data = 8'bZZZZZZZZ;

	end




endmodule
