nedopc/zxevo/tools/unreal_fix/0.37.6/tmp/atm.cpp

#include "std.h"

#include "emul.h"
#include "vars.h"
#include "memory.h"
#include "draw.h"

void atm_memswap()
{
   if (!conf.atm.mem_swap) return;
   // swap memory address bits A5-A7 and A8-A10
   for (unsigned start_page = 0; start_page < conf.ramsize*1024; start_page += 2048) {
      unsigned char buffer[2048], *bank = memory + start_page;
      for (unsigned addr = 0; addr < 2048; addr++)
         buffer[addr] = bank[(addr & 0x1F) + ((addr >> 3) & 0xE0) + ((addr << 3) & 0x700)];
      memcpy(bank, buffer, 2048);
   }
}

void AtmApplySideEffectsWhenChangeVideomode(unsigned char val)
{
    int NewVideoMode = (val & 7);
    int OldVideoMode = (comp.pFF77 & 7);

    // Константы можно задать жёстко, потому что между моделями АТМ2 они не меняются.
    const int tScanlineWidth = 224;
    const int tScreenWidth = 320/2;
    const int tEachBorderWidth = (tScanlineWidth - tScreenWidth)/2;
    const int iLinesAboveBorder = 56;

    int iRayLine = cpu.t / tScanlineWidth;
    int iRayOffset = cpu.t % tScanlineWidth;
/*    
    static int iLastLine = 0;
    if ( iLastLine > iRayLine )
    {
        printf("\nNew Frame Begin\n");
        __debugbreak();
    }
    iLastLine = iRayLine;
    printf("%d->%d %d %d\n", OldVideoMode, NewVideoMode, iRayLine, iRayOffset);
*/

    if (OldVideoMode == 3 || NewVideoMode == 3)
    {
        // Переключение из/в sinclair режим не имеет полезных побочных эффектов
        // (по словам AlCo даже синхра сбивается)
        for(unsigned y = 0; y < 200; y++)
        {
            AtmVideoCtrl.Scanlines[y+56].VideoMode = NewVideoMode;
            AtmVideoCtrl.Scanlines[y+56].Offset = ((y & ~7) << 3) + 0x01C0;
        }
        return;
    }

    if (OldVideoMode != 6 && NewVideoMode != 6)
    {
        // Нас интересуют только переключения между текстовым режимом и расширенными графическими.
        // Текстового режима нет ни до, ни после переключения. 
        // Следовательно, нет и побочных эффектов.
        
        // Распространяем новый видеорежим на неотрисованные сканлинии
        if (iRayOffset >= tEachBorderWidth)
            ++iRayLine;

        while (iRayLine < 256)
        {
            AtmVideoCtrl.Scanlines[iRayLine++].VideoMode = NewVideoMode;
        }
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
