nedopc/zxevo/(commit log)

2009-11-21 Added AVR files: last stable (_ver0.00) and current (under development, broken now) main firmware
    [depacker_dirty.c, depacker_dirty.h, getfaraddress.h, interrupts.c, main.c, pins.h, ps2.c]
2009-11-22 Compiled and fixed rev8
    [zx.c]
2009-11-23 Added AVRBOOT and some tools Changed Makefile for AVR (auto create firmware for bootloader) (А что, комментарии кириллицей ни как нельзя?)
2009-11-26 Previous fix goes to _ver0.02
    [T80.vhd, T80_ALU.vhd, T80_MCode.vhd, T80_Pack.vhd, T80_Reg.vhd, T80a.vhd, arbiter.v, dram.v]
2009-12-02 Just added ZXEVO_FW.BIN to avr/current/default/
2009-12-02 complete testbench. does not work.
    [tb_top.v]
2009-12-03 T80 does not work in simulation
    [tb_top.v]
2009-12-03 resetter.v fixed for simulation
    [resetter.v]
2009-12-03 fixed bugs with Pullup1 going to vhld model
    [tb_top.v]
2009-12-05 Probably bugfix for NMOS bug; changed Makefile in avr/ to automatically take top.rbf from fpga/current
    [zmem.v]
2009-12-06 Fix Lock48K Variant for Lock128K ("koe's style" string in zports.v)
    [zports.v]
2009-12-07 starting redesign from two clocks (zports.v) to single clock (fclk) and zpos-zneg strobes (zclock.v). May be broken now, not tested in hardware
    [slavespi.v, top.v, zclock.v, zports.v]
2009-12-19 fix LAZHA in fuse/lock bit ;)
2009-12-25 AVRBOOT: Fix critical error in SD-driver.
2010-01-13 update Flasher. Add video-out, fix some bugs (64K limit, etc) delete garbage.
    [lpm_ram_dp0.v, lpm_rom0.v, main.v]
2010-01-14 AVRASM32 (from Atmel) replaced AVRA (ГНУ)
2010-01-14 making new SPI slave engine in FPGA, not tested by now, and can be totally broken!
    [slavespi.v, top.v, zkbdmus.v, zports.v, zx.c, zx.h]
2010-01-17 probably bug in rev67 fixed
    [slavespi.v]
2010-01-18 bugs fixed, kbd works now
    [rs232.h, slavespi.v, top.v, zkbdmus.v, zx.c]
2010-01-23 support mouse and atx power supply
2010-01-24 Documentation on rev B
    [detali.ods]
2010-01-24 wait-regs for gluck clocks made: gluck rom not working without software support in atmega; press F9-F11 to reset out of gluck rom.
    [slavespi.v, top.v, zports.v, zwait.v]
2010-01-26 vga scan-doubling initial commit (mey not work)
    [top.v, vga_double.v, vga_synch.v]
2010-01-26 VGA mode WORKS!. avr is not updated, at rev.76. Needs adding clock support. gluckrom won't work. Use BBMV to upload directly to FPGA
    [top.v, vga_double.v]
2010-01-27 probably status bug fixed
    [main.c]
2010-01-28 vga-only; picture brightness corrected; mouse bug fixed (was X=Y); gluclock works, but badly
    [zx.c]
2010-01-28 border brightness fixed, vga on-off added (AVR control), docs has now 'supported_monitors' file
    [slavespi.v, top.v]
2010-01-28 Switcher VGA/non-VGA on SCROLL LOCK. RTC some features (write/read NVRAM cells).
2010-01-29 fix bug this year saving to rtc
    [rtc.c, zx.c]
2010-01-29 _ver1.00 is fixed in avr and fpga subdirs - first usable!
    [T80.vhd, T80_ALU.vhd, T80_MCode.vhd, T80_Pack.vhd, T80_Reg.vhd, T80a.vhd, arbiter.v, atx.c]
2010-01-31 fix video out (TV and VGA)
    [vga_double.v, vga_synch.v]
2010-02-03 slave spi addressing changed, KJ port added (see spi_fmt.txt)
2010-02-04 new spi mapping and joystick support
2010-02-15 fix vga video (black band on border)
    [vga_double.v]
2010-02-21 - fix Gluk C reg UF bit behaviour (thanks Savelij) - update comments and headers
    [depacker_dirty.c, depacker_dirty.h, main.c, main.h, rtc.c, rtc.h, zx.h]
2010-02-21 Добавил тулзу sjasmplus в соотвествующую диру
2010-02-21 Выложил сорцы и сборщик сервис прошивки. Рядом с РОМ файлом прошивки выложил Фаталл ввиде кодового блока в формате Хобета.
2010-02-22 Версия прошивки 0.11. Исправлен первый глюк
2010-02-22 Исправил еще пару глюков. Поправил/дополнил доку
2010-02-23 Fix mapping gluk (DS12887) nvram to PCF8583.
    [main.h, rtc.c]
2010-02-24 Отписал про Самсунг 2250G
2010-02-24 Добавил для теста Рейдж, обновил версию сервиса до 0.13 (добавил поддержку SMUC)
2010-02-25 Собрал фаталл 0.22. Поборол дискоглюки и сделал страничную листалку по файлам. Выложил в хобете для запуска из сервиса. Искать здесь: rom\page0
2010-02-28 Мелкое исправление без изменения версии. Добавил шрифты для будущей перестройки.
2010-03-01 Фаталл и рейдж переехал в диру nedopc\soft\hobetas
2010-03-08 Add PS2 keyboard led controlling: "Scroll Lock" led equal VGA mode.
2010-03-10 Обновил НЕ ГЛЮК до версии 0.14. Исправил невыставление режимов при переходе в бейсики и тырдос. Подправил проверку умоса.
2010-03-10 fix AAA keyboard bug
    [interrupts.c, main.c, ps2.c, rtc.c, zx.c, zx.h]
2010-03-10 atm-mem: intermediate commit (not working)
    [T80.vhd, T80_ALU.vhd, T80_MCode.vhd, T80_Pack.vhd, T80_Reg.vhd, T80a.vhd, arbiter.v, atm_pager.v]
2010-03-17 Перенес описание и хистори на НЕ ГЛЮК
2010-03-17 Версия НЕ ГЛЮК 0.15. Устранил ошибку невозможности выбора дисковода при отсутствии часов.
2010-03-19 Исправил вылезшие старые дрожжи. Не обнулялась без часов одна переменная. Номер версии и дока без изменений.
2010-03-21 - "Print Screen" PS2 keyboard key set NMI on ZX. - Soft reset (Z80 only) to service (0) page if pressed "softreset" key <5 seconds. - documentation
    [atx.c, interrupts.c, main.h, rtc.c, zx.c, zx.h]
2010-03-23 bin2v/win32 added (requires msvcrt90.dll to run), some nedobug fixed
    [top.v]
2010-03-24 Fix Power Led behavior (it off while atx power off).
    [atx.c, main.c, main.h]
2010-03-24 поправлена процедура обмена с SD картой
2010-03-24 -устранена проблема с обновлением после работы флешера (приходилось отключать питание) +поддержка VGA режима ("вспоминает" текущий режим из NVRAM) *изменения в процедуре обмена с SD карточками. (не р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
2010-03-25 Fix PS/2 timeout error handler.
    [interrupts.c, main.h, ps2.c]
2010-03-27 - Add support for get version info (via Gluk cmos extra registers 0xF0..0xFF). - Optimize sources, some correction (log, fpga load).
    [atx.c, depacker_dirty.c, depacker_dirty.h, joystick.c, main.c, main.h, ps2.c, rtc.c]
2010-03-27 Swap bytes in release date packing.
    [main.c, version.h]
2010-03-27 Испек версию 0.16 НЕ ГЛЮКа с отображением версий прошивок Пентевы.
2010-03-28 Fix PS/2 mouse error handler (analize error and reinit mouse if need it)
    [main.h, ps2.c]
2010-03-28 AVRBOOT, FLASHER, CRCBLDR - изменён формат хранения даты релиза (swap lo/hi bytes)
2010-03-29 Fix fpga load and ZX part init (optimize)
    [main.c, main.h, zx.c]
2010-04-27 probably fixed atm_mem bug
    [atm_pager.v, dram.v]
2010-04-29 merged atm_mem to current
2010-05-12 Пропатчил тырдос 6.10е. Прибил запись в порт #F7 и добавил модифицированное исправление от VELESOFT. Проверил только на анрыле. Но в порт #EFF7 тырдос уже не гадит.
2010-05-15 Выложил патченный тырдос 6.10. Доку отдельную не создавал. Все в сорце отписал.
2010-05-20 Сваял пзу не гдюка для АТМ (64к) и полное пзу (512к). Для АТМ не глюк еще не весь обезглючен. Некоторые резет сервисы рвут крышу. С инитом почти полностью разобрался, глюки поправлю чуть позже. Основ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
2010-05-21 Сваял версию НЕ ГЛЮК под номером 0.17. Серьезных изменений нет. Переписаны рестартовые кнопки, сделал версию для запуска без перекомпиляции и на пенте и на атм. Поправил драйвер винта. Дополнительным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
2010-05-22 Пока никуда не выложена вставил упущеный лейбл нарисованный robatом. Пока без анимации.
2010-06-01 Подправил доку на НЕ ГЛЮК, сделал сборщик апдейта для флешера с заголовком.
2010-08-04 Обновил НЕ ГЛЮК до версии 0.18, перенес кошкен на правую сторону и приделал анимацию, паузу анимации сделал пока маленькую. Добавил пункт загрузки с ленты.
2010-08-17 - "F9","F10","F11" on PS/2 keyboard not used for reset function. - "F12" on PS/2 keyboard worked like soft reset key. Short press (<5sec) - soft reset, long press (5sec) - hard reset and switch off A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
    [atx.c, atx.h, interrupts.c, main.c, main.h, ps2.c, zx.c, zx.h]
2010-08-20 Поправил НЕ ГЛЮК версии 0.18. В общем выкрутился за счет перенесения драйвера нгс ниже по адресам и только так избавился от глюка компилятора. Сейчас проблем вроде нет. Как далее будет не знаю. Номер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
2010-08-20 Забыл пересобрать прошивку для Пентевы которая на 64к размером.
2010-08-20 Сменил номер версии и пересобрал НЕ ГЛЮК
2010-08-26 fpga/current: adding SDcard in trdos, thinking about nemo-divide. added description of RS232 ports
2010-08-26 fixed f12+5sec no hardreset bug
    [atx.c]
2010-09-07 nemo-divide: fix try #1
    [zports.v]
2010-09-08 nemo-divide: fix try #2
    [zports.v]
2010-09-08 nemo-divide: fix try #3
    [zports.v]
2010-09-09 nemo-divide: finally fixed normal read: inir-read needs testing, otir-write not supported yet
    [zports.v]
2010-09-12 1) Add monitors to list 2) F12 not switch off power (only hard reset)
    [atx.c, main.h]
2010-09-14 fixed nemo-divide write; fixed makefile - case problems
    [zports.v]
2010-09-17 Сделал версию НЕ ГЛЮКа 0.1А, для тестирование, слишком много переделано. Нового только сброс нгса. Все что вспомнил вписал в хистори, в доке добалась 1 строчка про сброс нгса. Заодно заливаю асм с пр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
2010-09-19 Залил приготовленные к экзекуции сорцы TR-DOS 5.03
2010-09-19 Добавил в прошивку НЕ ГЛЮК сигнатуру и дату в вадироформате в последнии 8 байт по просьбе DDP. Пересобрал ром файлы. Залил считалку суммы для SCL файлов производства Deathsoft.
2010-10-09 Последняя версия не глюка, который на форуме выкладывал. Доку пока не переписывал.
2010-10-12 Сделал версию 0.2. Отказался от задуманных наворотов, сначала надо разобраться с менеджером памяти. Доки поправил. Вроде ничего не забыл. Если никакх проблем обнаружено не будет (на своей пентеве нен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
2010-10-13 changed to ATM-like ROM layout - zxevo_full.rom will work, zxevo_pent - will NOT WORK, turned on turbo in trdos
    [top.v]
2010-10-17 изм. в процедуре обмена с РS/2 клавиатурой (АСК при приёме)
2010-10-17 added just a comment to fpga/current sources
2010-10-18 branched current to atm_mem2 - almost finished, needs final test after negluck rom fixes
    [T80.vhd, T80_ALU.vhd, T80_MCode.vhd, T80_Pack.vhd, T80_Reg.vhd, T80a.vhd, arbiter.v, atm_pager.v]
2010-10-21 Исправлена ошибка из-за которой в турбе при создании рамдиска происходил сброс или зависало. Переделан инит манагера для атм режима.
2010-10-21 Немного дописал доку.
2010-10-22 Отловил еще один мелкий глючок и подновил доку на неглюк.
2010-10-23 changed reset to ATM-mode (with manager off), works ONLY with new services.rom!
    [atm_pager.v, zports.v]
2010-10-23 docs: updated base_config with NEW shadow-accessible EFF7/DFF7/BFF7 (pentagon & glukclock) port variants fpga/atm_mem2: fixed latest changes to atm memory functioning here
    [atm_pager.v, zports.v]
2010-10-31 trying to locate eef7 bug \(nothing found\)
    [rom_top.v, tb_top.v, testrom.v, zports.v, zwait.v, zxevo_rom.v]
2010-11-10 fpga/current: merged important changes from atm_mem2
2010-11-10 recompiled fpga/current with q72sp3
2010-11-10 убрал лишнее
2010-11-11 fpga/current: changed shadow gluclock access, added tapeout-beeper mux, docs changed accordingly, zxevo_fw.bin built accordingly
2010-11-12 tools/make_fw: changed source code name back to LOWER CASE, compiled new version for linux
2010-11-15 cAsE fix
2010-11-20 Закончил работу над ДОСом, наиздевался над 3,5 и 5,25 дисководами. Ничего страшного не обнаружил, все работает. Поэтому выкладываю EVO-DOS 0.11 и EVO Reset Service 0.23. Доку на EVO-DOS пока не начал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
2010-11-27 * - "NumLock" switch mode to beeper/pwm or tapeout ("NumLock" led light on tapeout mode). * - Create full translation map (0x00-0x7f for extended scan codes).
    update compatible monitors list
2010-11-28 Подправил кое-что по мелочи, изменил прошиватор. Доки поправил. Доки на еводос все еще нету. Еводос 0.13 и евосервис 0.24.
2010-11-29 fix documentation and make release 29.11.2010
    [rs232.c]
2010-11-29 fix: not create eeprom data
    [kbmap.c]
2010-12-06 В связи с воплями о не работе тех или иных программ (в основном игр) сделал некоторые исправления.
2010-12-07 Повоевал тут с свн, вроде все восстановил.
2010-12-08 Убрал пункт копирования дискет из сервиса, все равно не работает. А исправить забывайтунг ;)
2010-12-29 Весрии EVO-DOS 0.16 и EVO Service 0.27. Доки только такие осилил. На реале проверил. Запуск и работа IS-DOS особенно в турбе это нечто. И все надо проверять. Но проблем вроде не видно.
2010-12-30 По горячим следам пока предыдущая версия не попала на сайт. Версии EVO-DOS 0.17 и EVO Service 0.28 с исправленными ошибками
2011-01-08 Исправил ошибку загрузчика FDI образов и прибил супербумкалку.
2011-01-22 Исправил найденные ошибки, добавил перехват LDIR в досе. Более ничего нового не вносил пока.
2011-01-24 AVRBOOT v101231 (релиз "задним числом";)
2011-01-24 засунул в файл прошивки zxevo_bl.* ещё и test&service
2011-01-26 T&S (уже чуть лучше;)
2011-01-26 Устранил невозможность отформатировать реальный диск в досе.
2011-01-30 atm_video: merged 'current' branch
2011-02-07 Небольшие изменения в еводосе.
2011-02-12 Версии евосервис/еводос 032/021. Исправление ошибок.
2011-02-16 atm_video: added forgotten interrupt generation
2011-02-16 atm_video: corrected some little typos
    [top.v, video_top.v]
2011-02-17 atm_video: fixed some more typos
    [video_fetch.v, video_render.v, video_top.v, zwait.v]
2011-02-17 atm_video: fixed more typos
    [video_outmux.v, video_top.v]
2011-02-17 atm_video: bugs fixed, ready to add videomodes
    [video_addrgen.v, video_fetch.v, video_sync_v.v, video_top.v]
2011-02-27 atm_video: fixed flash and bitreverse, still errors in fetching
    [video_render.v]
2011-02-27 atm_video: fixed and tested modes: zx, zx-multicolor, zx-16c, atm-16c. atm-640 and atm-text not tested yet
    [video_fetch.v, video_palframe.v, video_render.v]
2011-02-27 atm_video: merged to current, everything seems to work except text-mode
2011-02-27 Версии евосервис/еводос 0.33/0.22. Добавил 2 диры для страниц ROM, но пока не свню. Там все только начинается.
2011-02-28 fpga/current: added correct memory init to fontrom, NOT TESTED YET!
2011-02-28 fixed fontrom (символы уже видно)
    [video_render.v]
2011-02-28 Евосервис/еводос 0.33/023. Исправил зависание из за запрещенных прерываний при выходе из перезватчика портов.
2011-02-28 begin making insertfixup for rbtree
2011-02-28 oops wrong comment. fixed small typo in video_render.v
    [video_render.v]
2011-03-01 textmode: fixed start address, not fixed attr shit :(. also zxevo_fw rebuilt
    [video_addrgen.v]
2011-03-02 atm_textmode: trying to fix...
    [video_addrgen.v, video_render.v]
2011-03-04 fpga/current: fixed attr/pix text mode, still right symbol is absent, zxevofwbin built
2011-03-08 Test&Service (110308) +недодока
2011-03-08 фак... не удалился. теперь удалил.
2011-03-08 fixing textmode 1symb shift...
    [video_fetch.v, video_sync_h.v, video_top.v]
2011-03-08 fpga/current: textmode finally fixed, zxevofwbin made
    [video_sync_h.v, video_top.v]
2011-03-08 fpga/current: probably fixed textmode 1st line, not tested nor compiled! only src change
    [video_addrgen.v]
2011-03-09 Fix RTC PC8583 dayweek 0..6 convert to DS12788 dayweek 1..7 and vice versa.
    [main.h, rtc.c]
2011-03-13 fpga/current: textmode fixed, covox (FB) added, zxevofwbin built
    [sound.v, top.v, video_addrgen.v, video_render.v, zports.v]
2011-03-17 Исправил ошибку не работы некоторых демок из за исправлений внесенных в басик48. Сделал редактор кмос для текстмода.
2011-03-19 Евосервис 0.35. Небольшые доработки.
2011-03-22 - Add access to 0..EF cells of PC8583. - Fix RTC PC8583 dayweek 0..6 convert to DS12788 dayweek 1..7 and vice versa.
    [main.h, rtc.c]
2011-03-22 Евосервис 0.36. Исправлена ошибка загрузки некоторых SCL файлов.
2011-03-23 Евосервис 0.37. Доработка редактора CMOS.
2011-03-24 Еводос 0.25. Поправил перехват LDIR.
2011-04-01 - fix RTC (return normal speed)
    [rtc.c]
2011-04-02 fixed: random write to cmos bug, border shift in RAGE bug
    [top.v, video_sync_h.v]
2011-04-13 - Add RS232 supporting. - Increase delay for reset FPGA (nCONFIG pin) before download it.
    - Add supported monitors to list.
    [main.c, main.h, pins.h, rs232.c, rs232.h]
2011-05-01 переписаны тесты видео и однобитного звука
2011-05-02 Revision C started
    [Pentagon.SCH, zxevo_light1.pcb]
2011-05-04 Попилил немного ошибки доса и сделал грузилку онли для TAP файлов.
2011-05-09 Немного понаводил порядок в сервисной паге и заодно пристроил к использованию Глюка. Все равно место в пзу жо сих пор занимает.
2011-05-09 Укоротил имя ром файла.
2011-05-10 Revision C update
    [zxevo.sch]
2011-05-11 added 2 additional audioinputs
    [Pentagon.SCH, zxevo.sch]
2011-05-11 scheme up
    [zxevo.pcb, zxevo.sch]
2011-05-12 added csync repeater to schematics
    [zxevo.sch]
2011-05-15 merged from current to atm_nmi
2011-05-16 up scheme
    [zxevo.pcb, zxevo.sch]
2011-05-16 Сваял версию 0.4. С загрузчиком шрифтов с фат и из пзу. Сделал отключаемый драйвер ау принтера.
2011-05-23 up pcb
    [zxevo.pcb, zxevo.sch]
2011-05-31 atm_nmi: int to be shifted, palette read tested, nmi not working yet
    [video_sync_h.v]
2011-06-05 atm_nmi merging with current
2011-06-08 base configuration on english add
    [zxevo.pcb]
2011-06-10 fpga/current: fixed INT position
    [video_sync_h.v]
2011-06-11 up pcb and sch
    [zxevo.pcb, zxevo.sch]
2011-06-11 fpga/current: border fix #2
    [video_sync_h.v]
2011-06-11 fpga/current: fixed INT length to ~14us - now hexafiller in multicolor catches int correctly
    [zint.v]
2011-06-11 fpga/current: changed pages readback from non-inversed to inversed
2011-06-13 rev C up
    [zxevo.pcb]
2011-06-17 pcb revision C up
    [zxevo.pcb]
2011-06-24 USB-RS232 bridge add
    [zxevo.sch]
2011-06-26 USB-RS232 bridge on FT232RL
    [zxevo.sch]
2011-06-26 rev_C - changed ft232 connection on SCH, added 2 vias on PCB
    [zxevo.pcb, zxevo.sch]
2011-06-27 finalize pcb routing and send to "rezonit"
    [zxevo.pcb, zxevo.sch]
2011-07-05 fpga/z14: now even 7mhz broken (does not goes to evoservice menu)
    [tb_top.v, zmem.v]
2011-07-13 fpga/z14: fixed sdcard for 14mhz
    [top.v, zports.v]
2011-07-14 z14: merged with current>
2011-07-14 z14: merged with current
2011-07-18 fpga/current: added 16bit buffer for read data
2011-07-18 up docs
    [bom.ods, zxevo.sch]
2011-07-21 Сделал переключение турбо 3,5, 7, 14, сам сервис пока на частоте 7 остался. Расширирил файловое окно и сделал показ расширений файлов.
2011-07-22 Switching to beeper if value changed
2011-07-22 Исправил обнаруженную ошибку и переделал перебор и отображение текущего турборежима в виде цифр.
2011-07-31 fpga/current: added self-nmi-generation, added ports for savelij
2011-08-04 fpga/current: added slow_slew_rate=on, avr/current: compiled with new fpga firmware
2011-09-28 Обновление Evo Service, Evo-DOS, ProfROM. В прошивку Gluk вернул как оно должно быть.
2011-09-28 Обновил доку на Evo Service.
2011-10-09 Устранил ошибки и переделал турбокнопку в профром.
2011-12-04 Обновление. Поправил ProfROM, устранил кое какие мелочи. Кое что добавил в сервисах.
2011-12-05 Забыл при обновлении засвнить исходник теста PC клавиатуры.
2011-12-06 Очень мелкое исправление в CMOS editor.
2011-12-17 Некоторые мелкие доработки, ревизия сорцов.
2011-12-27 trying to fix multicolor bug
    [video_addrgen.v]
2011-12-27 multicolor bug fixed, only fpga
    [video_addrgen.v]
2012-01-01 Поправил пару мелочей. Подновил список поддерживаемых мониторов.
2012-01-01 Забыл обновить версию сервиса.
2012-01-03 updated TODO, created errors file for zxevo_base_configuration
    [zxevo_base_configuration.txt]
2012-01-04 Исправил номер прошивик custom rom, не туда прошивалось. А ведь проверял...
2012-01-06 updated base_configuration doc: fixed bugs
    [zxevo_base_configuration.txt]
2012-01-06 branched fpga/current to vmodes (videomodes)
2012-01-06 IDE fix try #1
    [zports.v]
2012-01-06 fpga: merged new 1page textmode from vmodes to current
2012-01-10 fixed unreal 0.37.6: pentevo features added
    [atm.cpp, bass.h, cheat.cpp, config.cpp, config.h, dbgbpx.cpp]
2012-01-13 Добавил bass.dll+bootGS.bin и pentevo.bat+pentevo.ini со своими настройками в диру Unreal.
2012-01-14 added to fpga/vmodes: NMI fix, after ROM 0066 M1 RAM page FF is on; AVR access to SDcard, see slave/spi_fmt.txt; fontrom readback (no Z80 examples yet)
    [nmitest_rom.v, rom_top.v, slavespi.v, spi2.v, spihub.v, spitest_avr.v, spitest_print.v, spitest_rom.v]
2012-01-14 пофиксил nemo-IDE и Z-SD под шадовмод
2012-01-14 FIX: PS2 keyboard hangup bug ADD: Autoreset PS2 keyboard log after overload (reading FF code)
    [main.h, ps2.c, zx.c]
2012-01-14 fpga/vmodes: fixed NMI a little, fixed AY ports 14mhz throttling bug (tnx to ts-labs), added source code for reading fontrom (no commentz yet)
    [znmi.v, zports.v]
2012-01-14 unreal_fix: changes http:// info in fix
    [emul.cpp]
2012-01-15 пофиксил пример работы с z-sd в шадовмоде. добавил пример расчёта адреса для нового текстмода.
2012-01-15 updated base_config: fixed NMI behavior; added #0EBE port (fontrom read); added DOS bit to 0CBE port in fpga/vmodes for TRDOS in NMI detection
    [zports.v]
2012-01-15 fpga/current: merged all features to current (avr sdcard access, updated NMI behavior, font read, some bugfixes), built new zxevo_fw.bin
    [nmitest_rom.v, rom_top.v, slavespi.v, spi2.v, spihub.v, spitest_avr.v, spitest_print.v, spitest_rom.v]
2012-01-15 unreal_fix: fixed port FF77 readback (was error in original), added TRDOS bit to FF77 readback port (0CBE), added fake ZXEVO fontread capability (only compatible with fontread.src), tested with fontr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
    [io.cpp, mainloop.cpp]
2012-01-18 Сделал поддержку кнопки Magic. Пока минимально.
2012-01-19 Исправил проблему неправильного считывания шрифта и вывода некоторых регистров в магик меню.
2012-01-23 Исправил ошибки при работе с принтера из-за чего зависало при выходе в Basic 48. Обновил и добавил шрифты.
2012-01-23 T&S and AVRboot. (приём данных с SD карты)
2012-01-24 Еще раз поменял шрифты :)
2012-01-24 unreal_fix 0.37.6: turned on NGS DMA in ZX-EVO mode, compiled; added some ini files, changed bootgs.rom to bootgs.bin in ini files
2012-01-25 unreal_fix: removed Z-controller debug printfs
2012-01-29 update docs
    [bom.ods]
2012-02-19 не сбрасывался бит переполнения фифо-приёма уарта. Извиняюсь, что влез без разрешения. протестил, бит стал сбрасыватся.
2012-04-10 unreal: direct access to ps/2 keyboard buffer(by thims) micro-fix rs232, empty receive_buffer zero returned(by me)
    [emul.ini, emulkeys.cpp, input.cpp, input.h, inputpc.cpp, io.cpp, memory.cpp, modem.cpp]
2012-04-11 unreal: fix ps2 in debug mode
    [input.cpp, io.cpp, memory.cpp]
2012-05-27 Версия 0.5. Изменения в доках
2012-12-03 Версия 0.51. Исправления ошибок. Новое пока не вставил. рст8 дока в недописанном состоянии.
2012-12-04 Версия 0.51a Мелкое исправление + мелкое исправление в evodos. Рабочий асм тоже обновлен.
2012-12-08 ers/evodos 0.52/0/33 исправил мелкие ошибки и сделал обнуление памяти для запуска басик прог
2012-12-26 Версия 052а. Пара мелких исправлений в драйверах.
2012-12-29 Исправил потерю шрифта в profrom
2013-01-20 Версия 0.52b исправлена ошибка обнуления секунд
2013-02-25 Версия 0.53 По требованию lvd добавил Perfect commander
2013-02-26 Версия 0.53а Восстановил работу FAT/SPG загрузчика
2013-04-02 unreal: changed bit4 of 0CBE to reflect remembered during NMI trdos state, not current trdos state
2013-04-17 Update PCB
    [zxevo_c2.pcb]
2013-05-18 Версия 0.53c Исправление ошибок
2013-06-18 added 60Hz video mode
2013-11-07 "60Hz" mode control change
2013-11-08 inverse signal 60Hz-mode; remove obsolete file
2013-11-17 Некоторые изменения в evo-dos папках. Добавил сорцы tr-dos 5.03 с устранения некоторых ошибок и небольшими изменениями от исходной версии.
2013-12-01 C-версия Test&Service может компилироваться текущей версией AtmelAVRToolchain.
2013-12-01 AVR может компилироваться текущей версией AtmelAVRToolchain.
2013-12-15 Прикрутил ATM CP/M, MSX-dos пока не стал добавлять, откатил EVO-DOS с некоторыми изменениями. Образ загрузочной дискеты с измененным FDISK залил в папку DOCS. Залил TR-DOS 6.11Е для GLUK прошивки, те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
2013-12-18 Версия ERS 0.54a. Исправил проблему невидимости файлов на больших карточках. Добавил доки на части Gluk service присланные Alone Coder'ом.
2013-12-20 Дописал в доку и хистори про просмотрщик BMP картинок который сделал еще год примерно назад.
2014-02-10 Мелкие исправления в evodos и ers. Добавлен загрузчик isdos в service menu. Свалил все доки и хистори в один документ. Старые доки за гегадобностью удалю позже.
2014-02-11 Перекомпилил со старым file browser вместо нового, был сломан обновитель ROM.
2014-02-16 Версия 0.54d с косметическими измениями. Создал папку zx_utils куда залил внешний обновлятор rom в 2-х видах (hobeta и scl) с сорцами. В прошлом обновлении удалил за ненадобностью лишние доки.
2014-02-16 Добавил проверку на размер файла во внешний обновлятор, дописал в доку про внешнюю утилиту обновления прошивок.
2014-02-19 Переименовал папку zx-utils в zx_soft. Добавил сорцы запускалки timegal с компиляцией в хобету.
2014-03-02 Test&Service: флешер: 1) правильно отображает финальное сообщение о результате записи; 2) обновлена распознавалка ROM-ом
2014-03-06 Test&Service: флешер: release флаг в бинарнике; history.txt
2014-03-25 Добавил сорцы утилиты загрузки tap и trd по компорту.
2014-03-29 Сделал версии zmodem загрузки для Пентагона 2.2 и Профи через zxmc2. На реале не проверялось, только в Unreal.
2014-03-30 unreal_fix 0376: added 8th color change, fix by Alone Coder
    [emul.ini]
2014-04-03 Небольшое изменение переключения 49<>60 (например, Shift+ScrollLock из "TV49" переключает в "TV60")
2014-04-03 В бинарник(hex,e2p) avrboot-а залит свежий Test&Service.
2014-04-08 ERS версия 0.55. Исправленный просмотрщик BMP и просмотр/запуск басик файлов из образов SCL/TRD
2014-04-13 avr: исправлены ошибки при работе с пользовательской раскладкой клавиатуры (kbmap from eeprom)
    [kbmap.c, zx.c]
2014-04-13 kmapper: тулза-редактор клавиатурной раскладки (win32) beta
2014-04-16 Версия 0.55а Мелкие исправления
2014-04-20 ERS 0.55b Исправил сброс при запуске hobeta и spg файлов.
2014-04-30 pentevo: int signal length corrected for extensive wait states: while wait_n==0, int length counter doesn't count
    [top.v, zint.v]
2014-05-16 - Add EEPROM access via RTC interface. - Add reset PS2 keyboard after error. - Fix change resolution command (need for some PS2 mouses).
    [kbmap.c, main.h, ps2.c, ps2.h, rtc.c, rtc.h, version.c]
2014-05-16 pentevo: added readback of some config register (50/60hz, tv/vga) via clock regs
2014-05-18 Версия ERS 0.55c Добавлена индикация видео режима
2014-05-18 Мелкое испраление доки на ERS
2014-05-19 Версия ERS 0.55d Исправление в определении фат при отсуствии мбр
2014-07-16 ERS v0.55e EVODOS v0.38 испраления ошибок
2014-07-17 ERS 0.55f Исправлено зависание при входе в Perfect commander
2014-07-18 Fix update_keys function in zx.c .
    [main.h, zx.c]
2014-07-29 pentevo: added ulaplus, fixed NMI to RAM (DimkaM request)
    [arbiter.v, atm_pager.v, dram.v, example.v, fapch_counter.v, fapch_zek.v, resetter.v, slavespi.v]
2014-08-04 Перезаливка, почему то не обновился бинарик пзу.
2014-08-05 Восстановил в батнике копирование бинарика прошивки в каталог Unreal
2014-10-05 Update: * - Add any (left or right) Ctrl,Alt keys and exclude mapped Ctrl,Alt keys from Ctrl-Alt-Del functionality (reset). * - Add reading state of LCTRL,RCTRL,LALT,RALT,LSHIFT,RSHIFT,F12 keyboard s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
    [interrupts.c, main.h, rtc.c, rtc.h, zx.c, zx.h]
2014-12-01 Мелкие изменения в коде и сборочно bat файле.
2014-12-08 docs: added Z80 appnote regarding interrupt modes (im0, im1, im2, nmi)
2014-12-08 evodos 0.40 исправлена небольшая ошибка
2015-01-13 correct patch of AVR firmware for new switching algo (only scrolllock: pent15khz->pent31khz->60hz15khz->60hz31khz->48k15khz->48k31khz->128k15khz->128k31khz->loop)
    [main.h, zx.c]
2015-01-14 ERS 0.56c Небольшое исправление и добавка дополнительных пзу.
2015-03-11 EVODOS 0.41 исправления
